MatthewWCook/Z80Project/Z80 RAM and Stack Test/Photos/RAMSTACKSchematic1.jpg

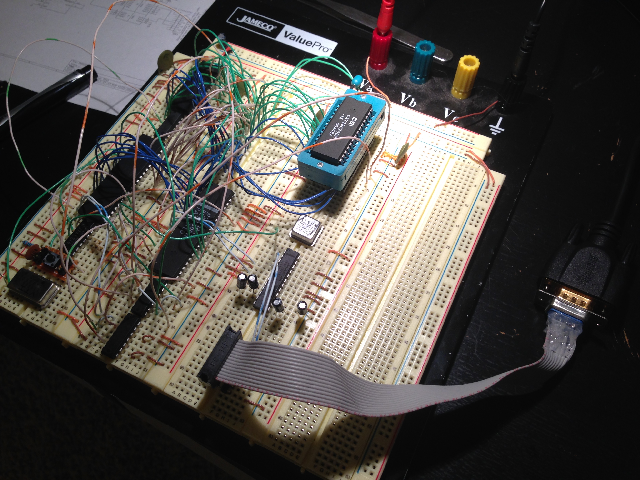
Z80 RAM and Stack Test/Photos/RAMSTACKSchematic1.jpg
