MatthewWCook/Z80Project/Z80 8bit CF Card Part 1/Photos/CFPIC2.PNG

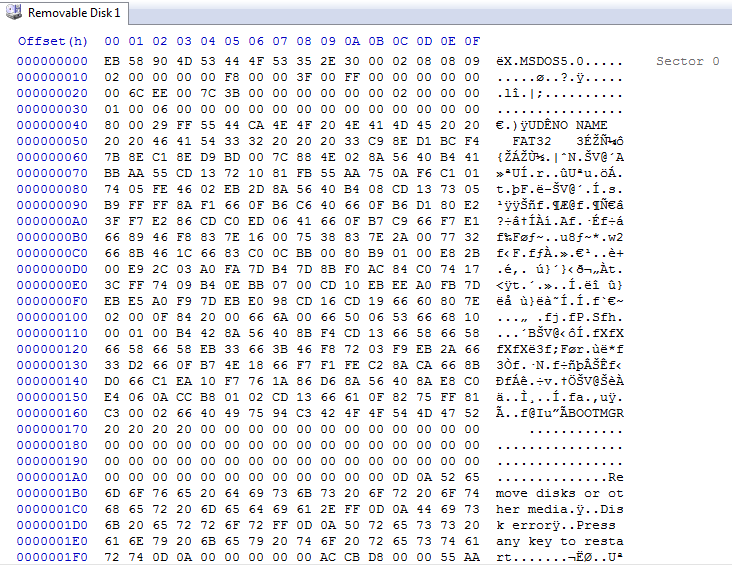
Z80 8bit CF Card Part 1/Photos/CFPIC2.PNG
