MatthewWCook/Z80Project/Z80 8bit CF Card Part 1/Photos/CFPIC3.PNG

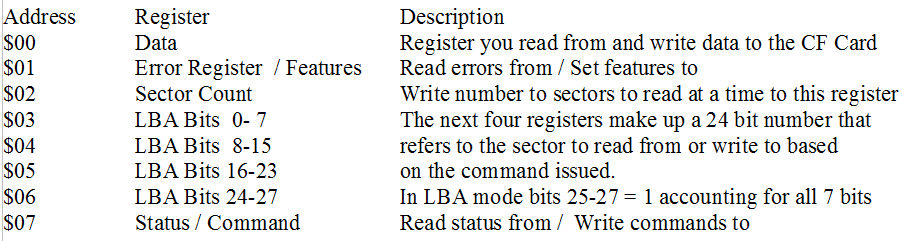
Z80 8bit CF Card Part 1/Photos/CFPIC3.PNG
