MatthewWCook/Z80Project/Z80 8bit CF Card Part 1/Photos/CFPIC4.png

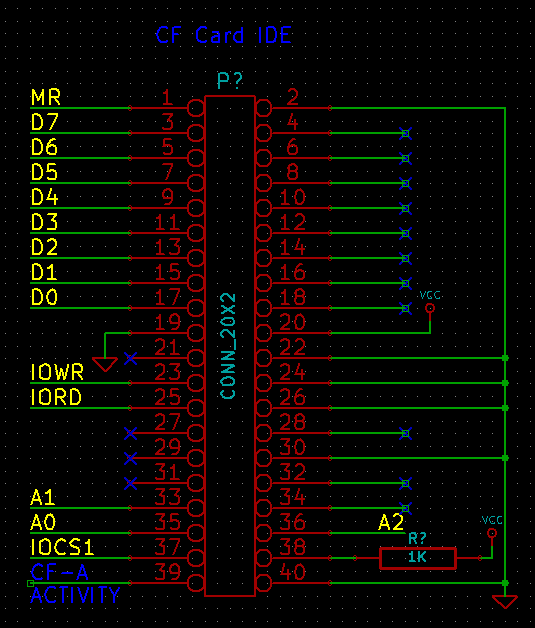
Z80 8bit CF Card Part 1/Photos/CFPIC4.png
