MatthewWCook/Z80Project/Z80 8bit CF Card Part 1/Photos/Photo Jul 05, 4 09 23 PM.jpg

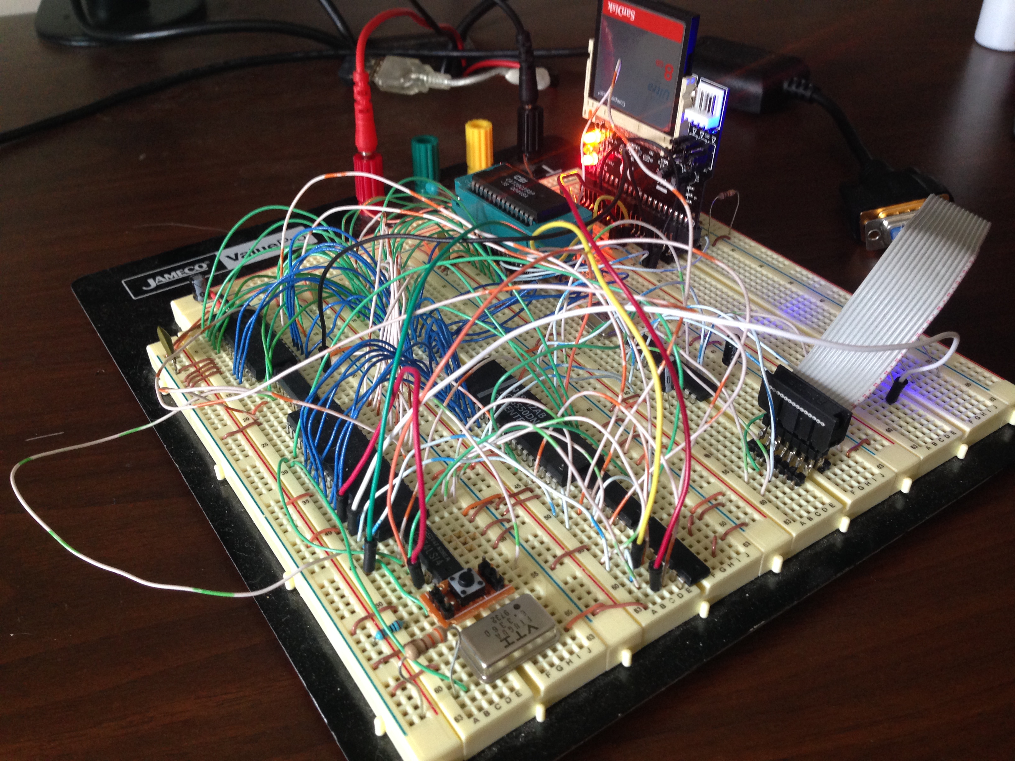
Z80 8bit CF Card Part 1/Photos/Photo Jul 05, 4 09 23 PM.jpg
