MatthewWCook/Z80Project/Z80 8bit CF Card Part 1/Photos/Photo Jul 05, 7 52 12 PM.jpg

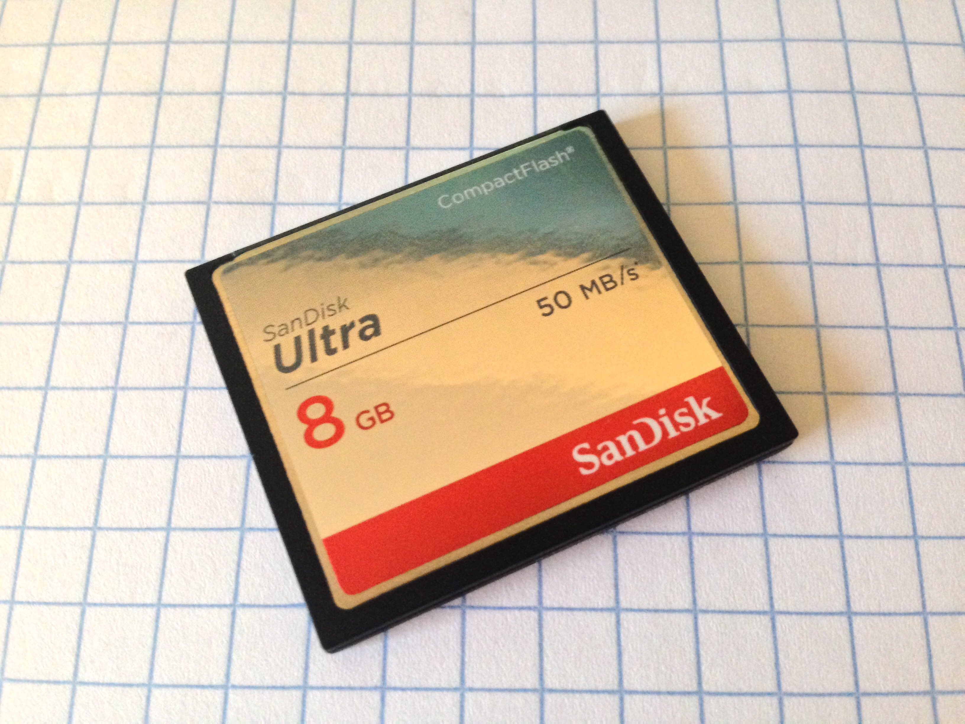
Z80 8bit CF Card Part 1/Photos/Photo Jul 05, 7 52 12 PM.jpg
