MatthewWCook/Z80Project/Z80 Interrupts and Strings/Photos/CAT1.jpg

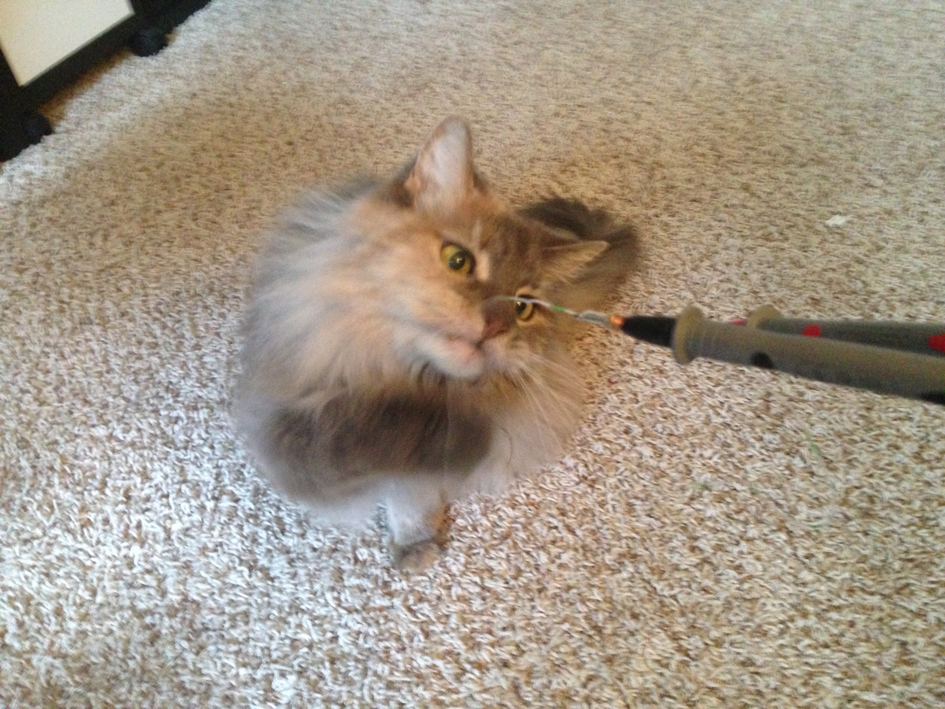
Z80 Interrupts and Strings/Photos/CAT1.jpg
