MatthewWCook/Z80Project/Z80 Interrupts and Strings/Photos/CAT2.jpg

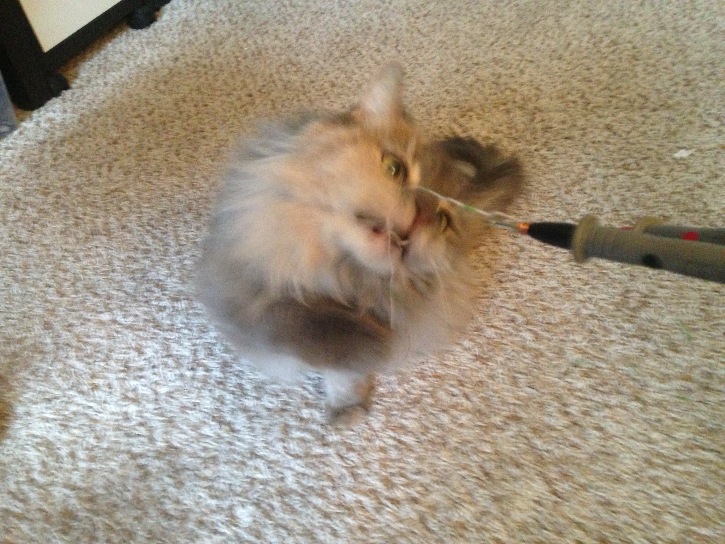
Z80 Interrupts and Strings/Photos/CAT2.jpg
