MatthewWCook/Z80Project/Z80 Interrupts and Strings/Photos/Z80IASOUTPUT.PNG

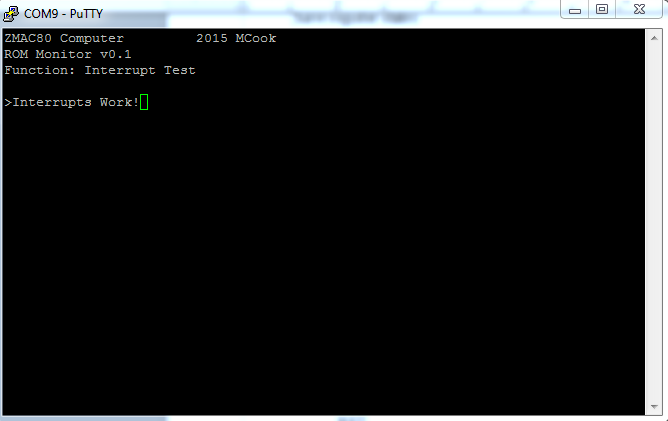
Z80 Interrupts and Strings/Photos/Z80IASOUTPUT.PNG
