MatthewWCook/Z80Project/Z80 Monitor Part 1/ROMMonitorPIC1.PNG

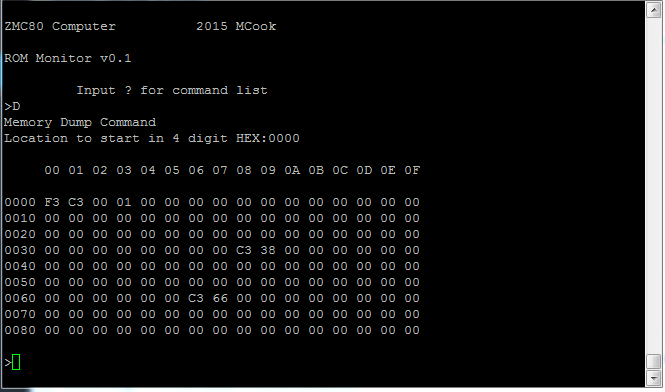
Z80 Monitor Part 1/ROMMonitorPIC1.PNG
