MatthewWCook/Z80Project/Z80 UART Serial Console Interface/Pictures/Photo1.jpg

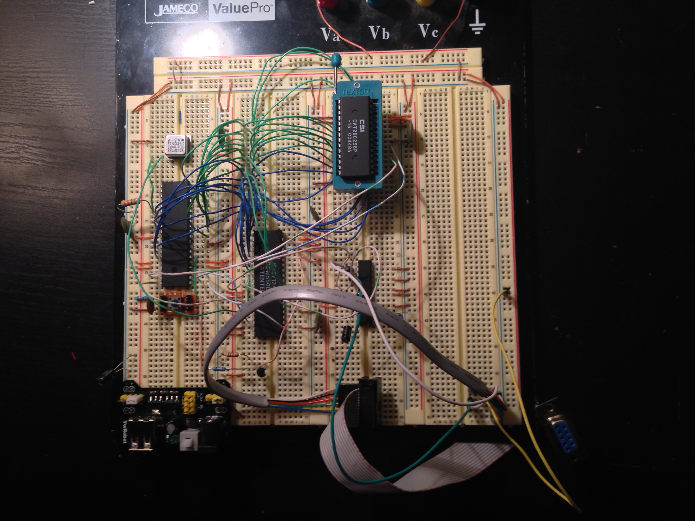
Z80 UART Serial Console Interface/Pictures/Photo1.jpg
