MatthewWCook/Z80Project/Z80 UART Serial Console Interface/Pictures/Photo2.jpg

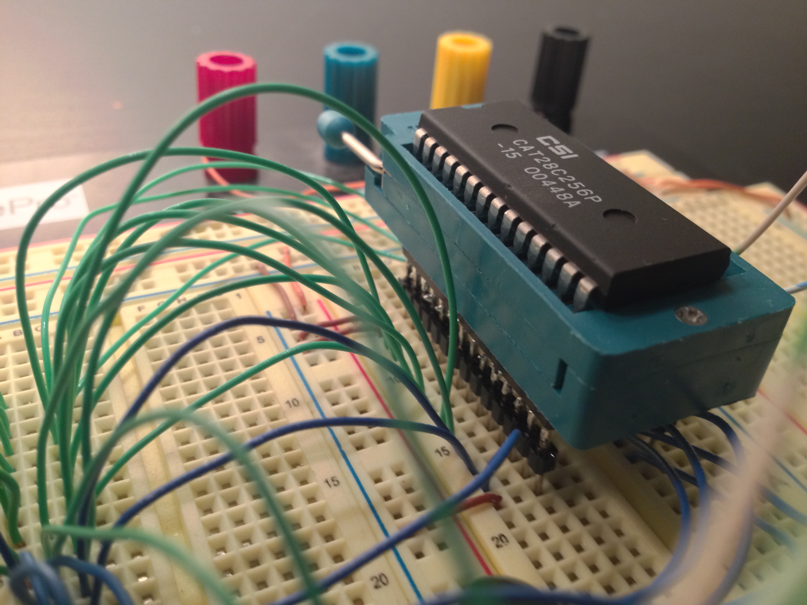
Z80 UART Serial Console Interface/Pictures/Photo2.jpg
