MatthewWCook/Z80Project/Z80 UART Serial Console Interface/Pictures/Photo3.jpg

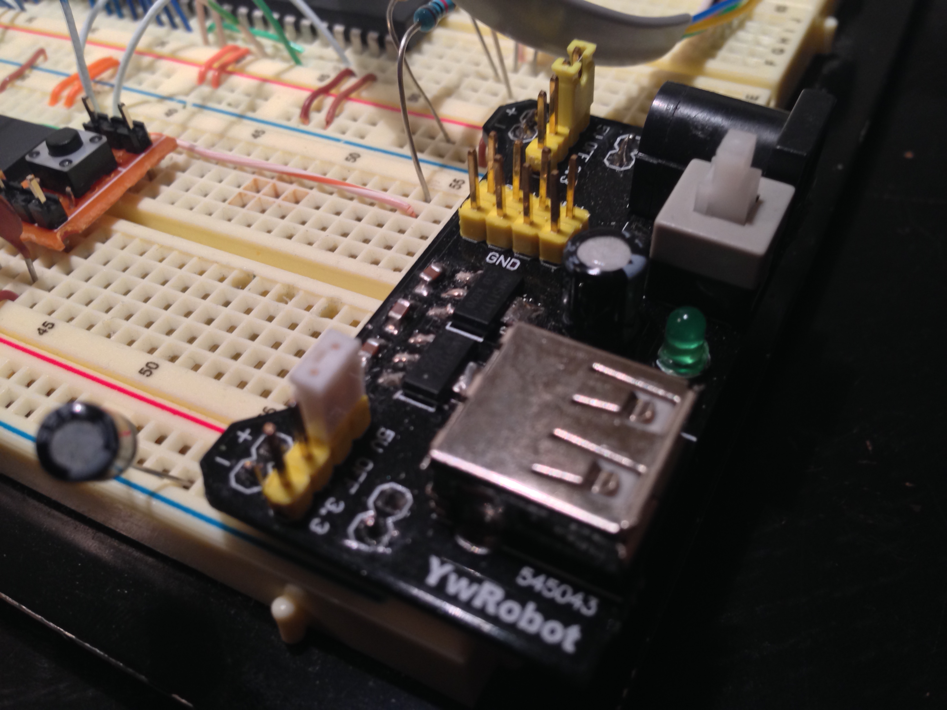
Z80 UART Serial Console Interface/Pictures/Photo3.jpg
