MatthewWCook/Z80Project/(list of files, cad)

Other CAD files:
Z80 8bit CF Card Part 1/Code/Z80Monitor.obj
Z80 Interrupts and Strings/Code/Z80Interrupt.obj
Z80 RAM and Stack Test/Code/STACKTEST.obj
Z80 UART Serial Console Interface/Code/UARTCONSOLE.obj
Z80 Monitor Part 1/Code/Z80Monitor.obj
