MatthewWCook/Z80Project/Z80 RAM and Stack Test/Photos/Output.PNG

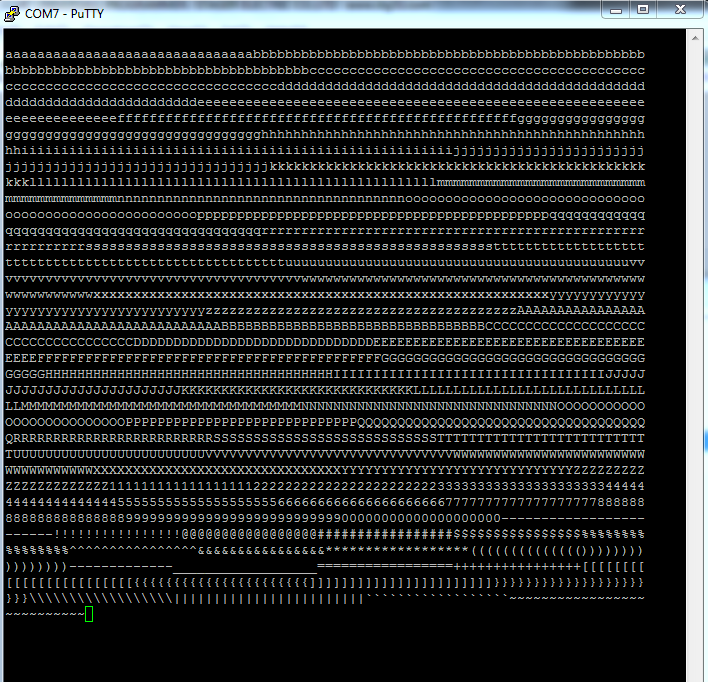
Z80 RAM and Stack Test/Photos/Output.PNG
