MatthewWCook/Z80Project/Z80 8bit CF Card Part 1/Schematic/PDF/Z80CFHDD1-bw.pdf

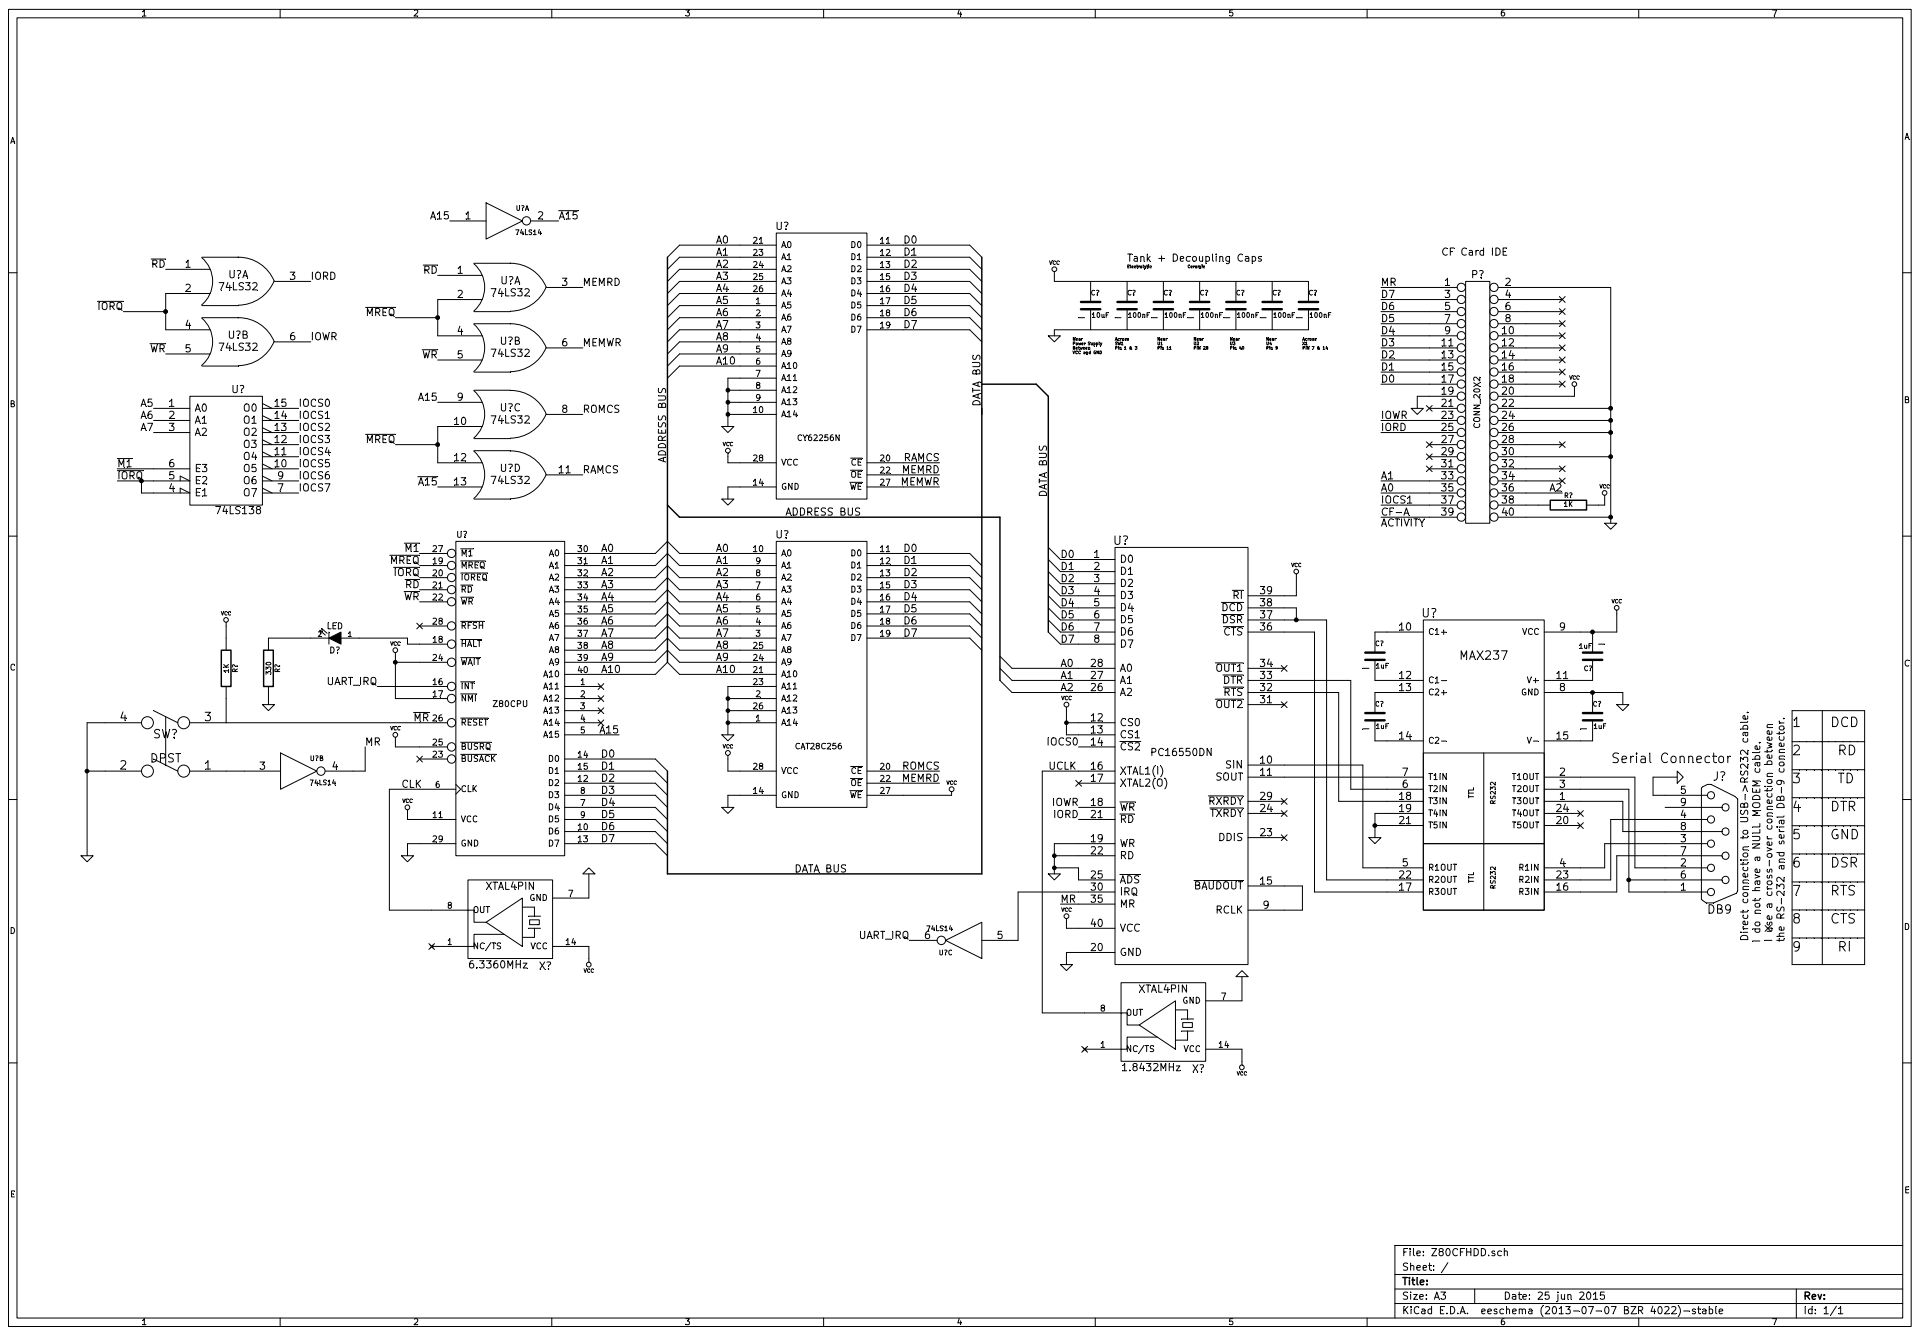
[picture p17: page 1]
