MatthewWCook/Z80Project/Z80 8bit CF Card Part 1/Schematic/PDF/Z80CFHDD1-color.pdf

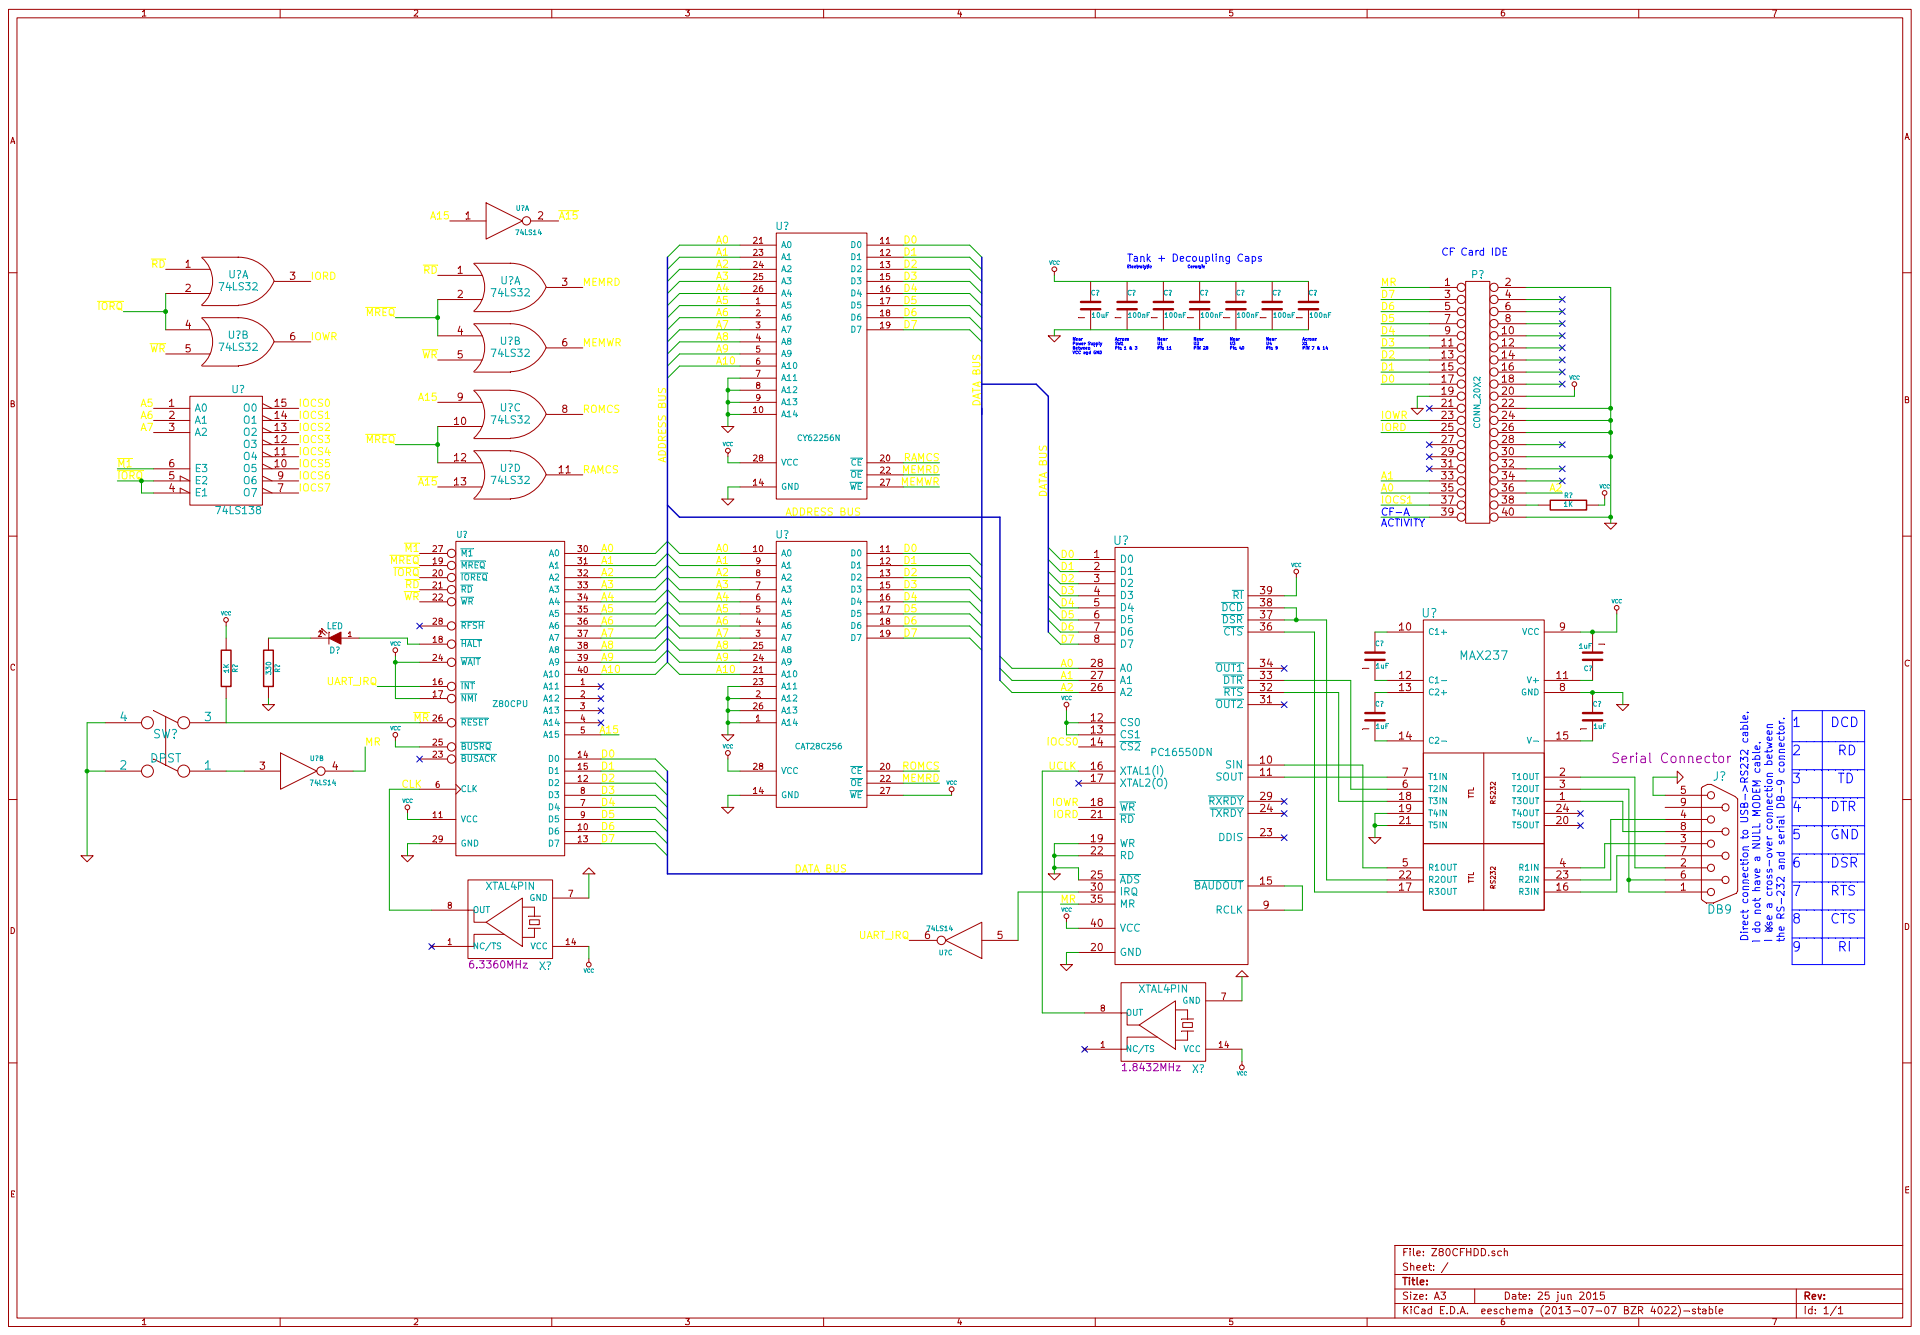
[picture p18: page 1]
