MatthewWCook/Z80Project/Z80 Interrupts and Strings/Schematic/PDF/Z80INTERRUPTSANDSTRINGS-bw.pdf

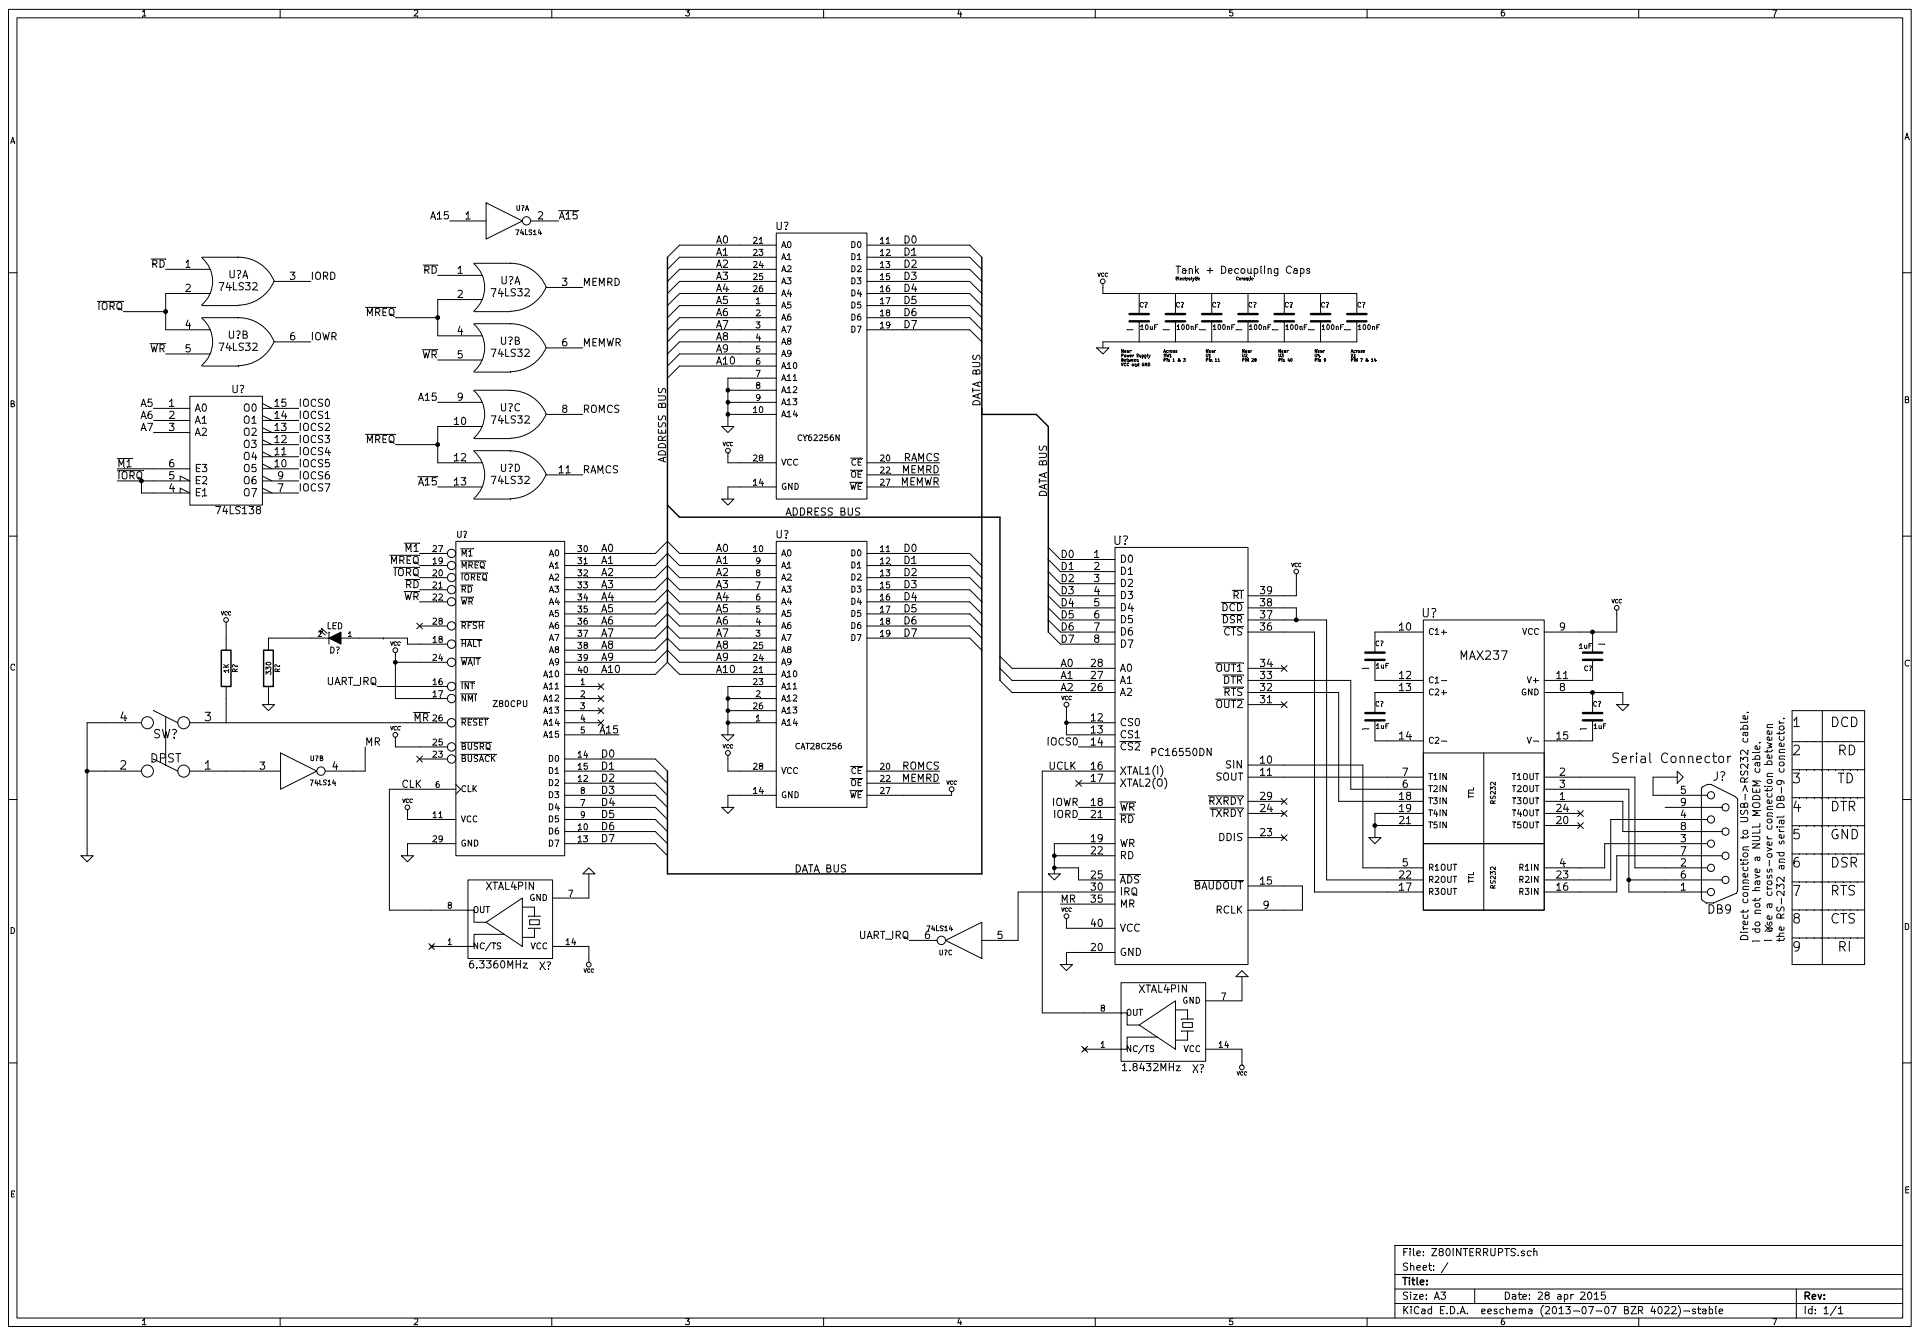
[picture p19: page 1]
