MatthewWCook/Z80Project/Z80 Interrupts and Strings/Schematic/PDF/Z80INTERRUPTSANDSTRINGS-color.pdf

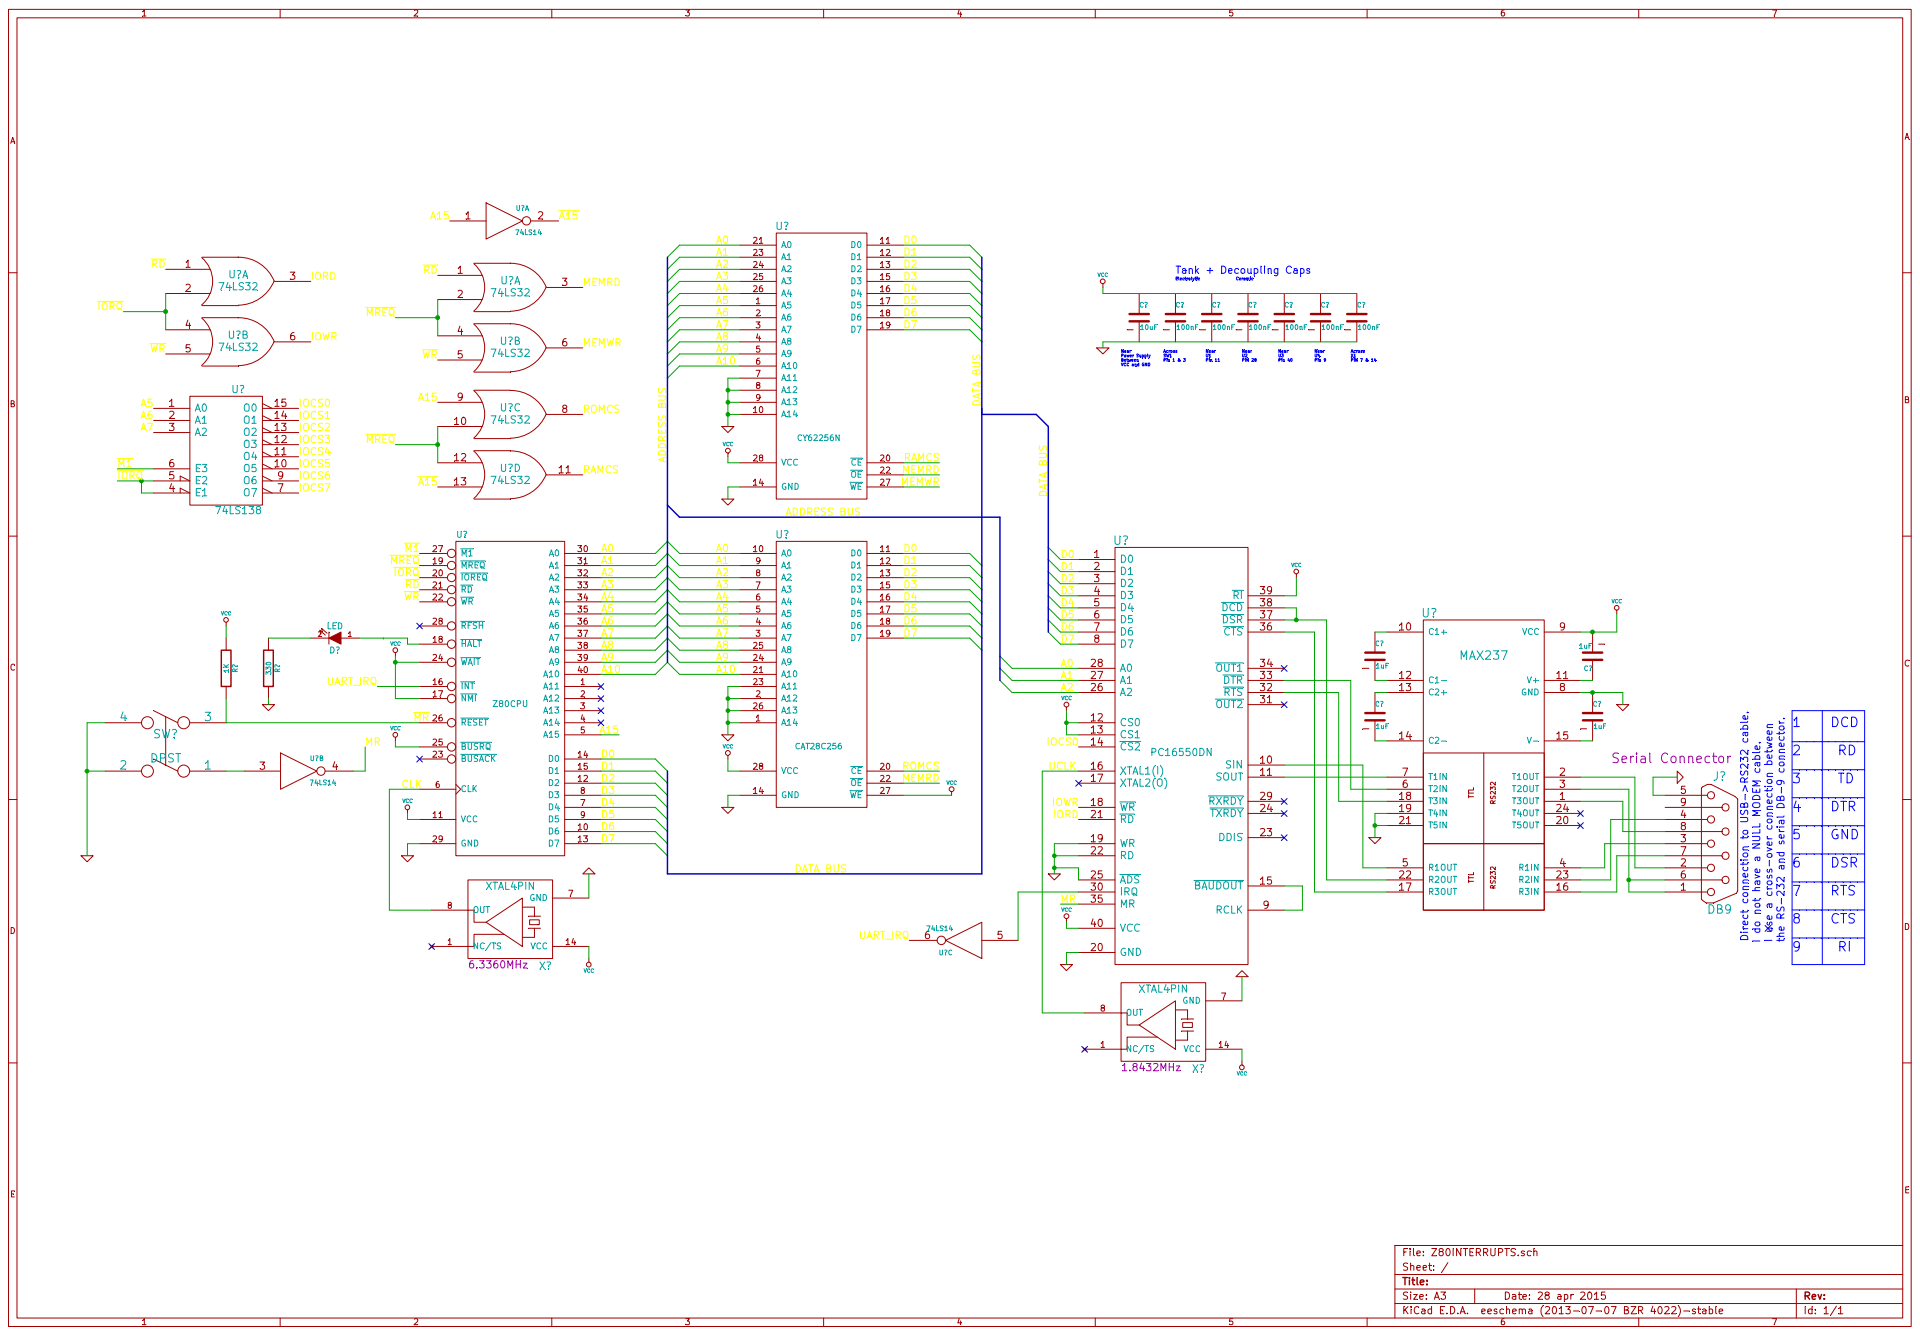
[picture p20: page 1]
