MatthewWCook/Z80Project/Z80 RAM and Stack Test/Schematic/PDF/Z80RAMSTACKTEST-bw.pdf

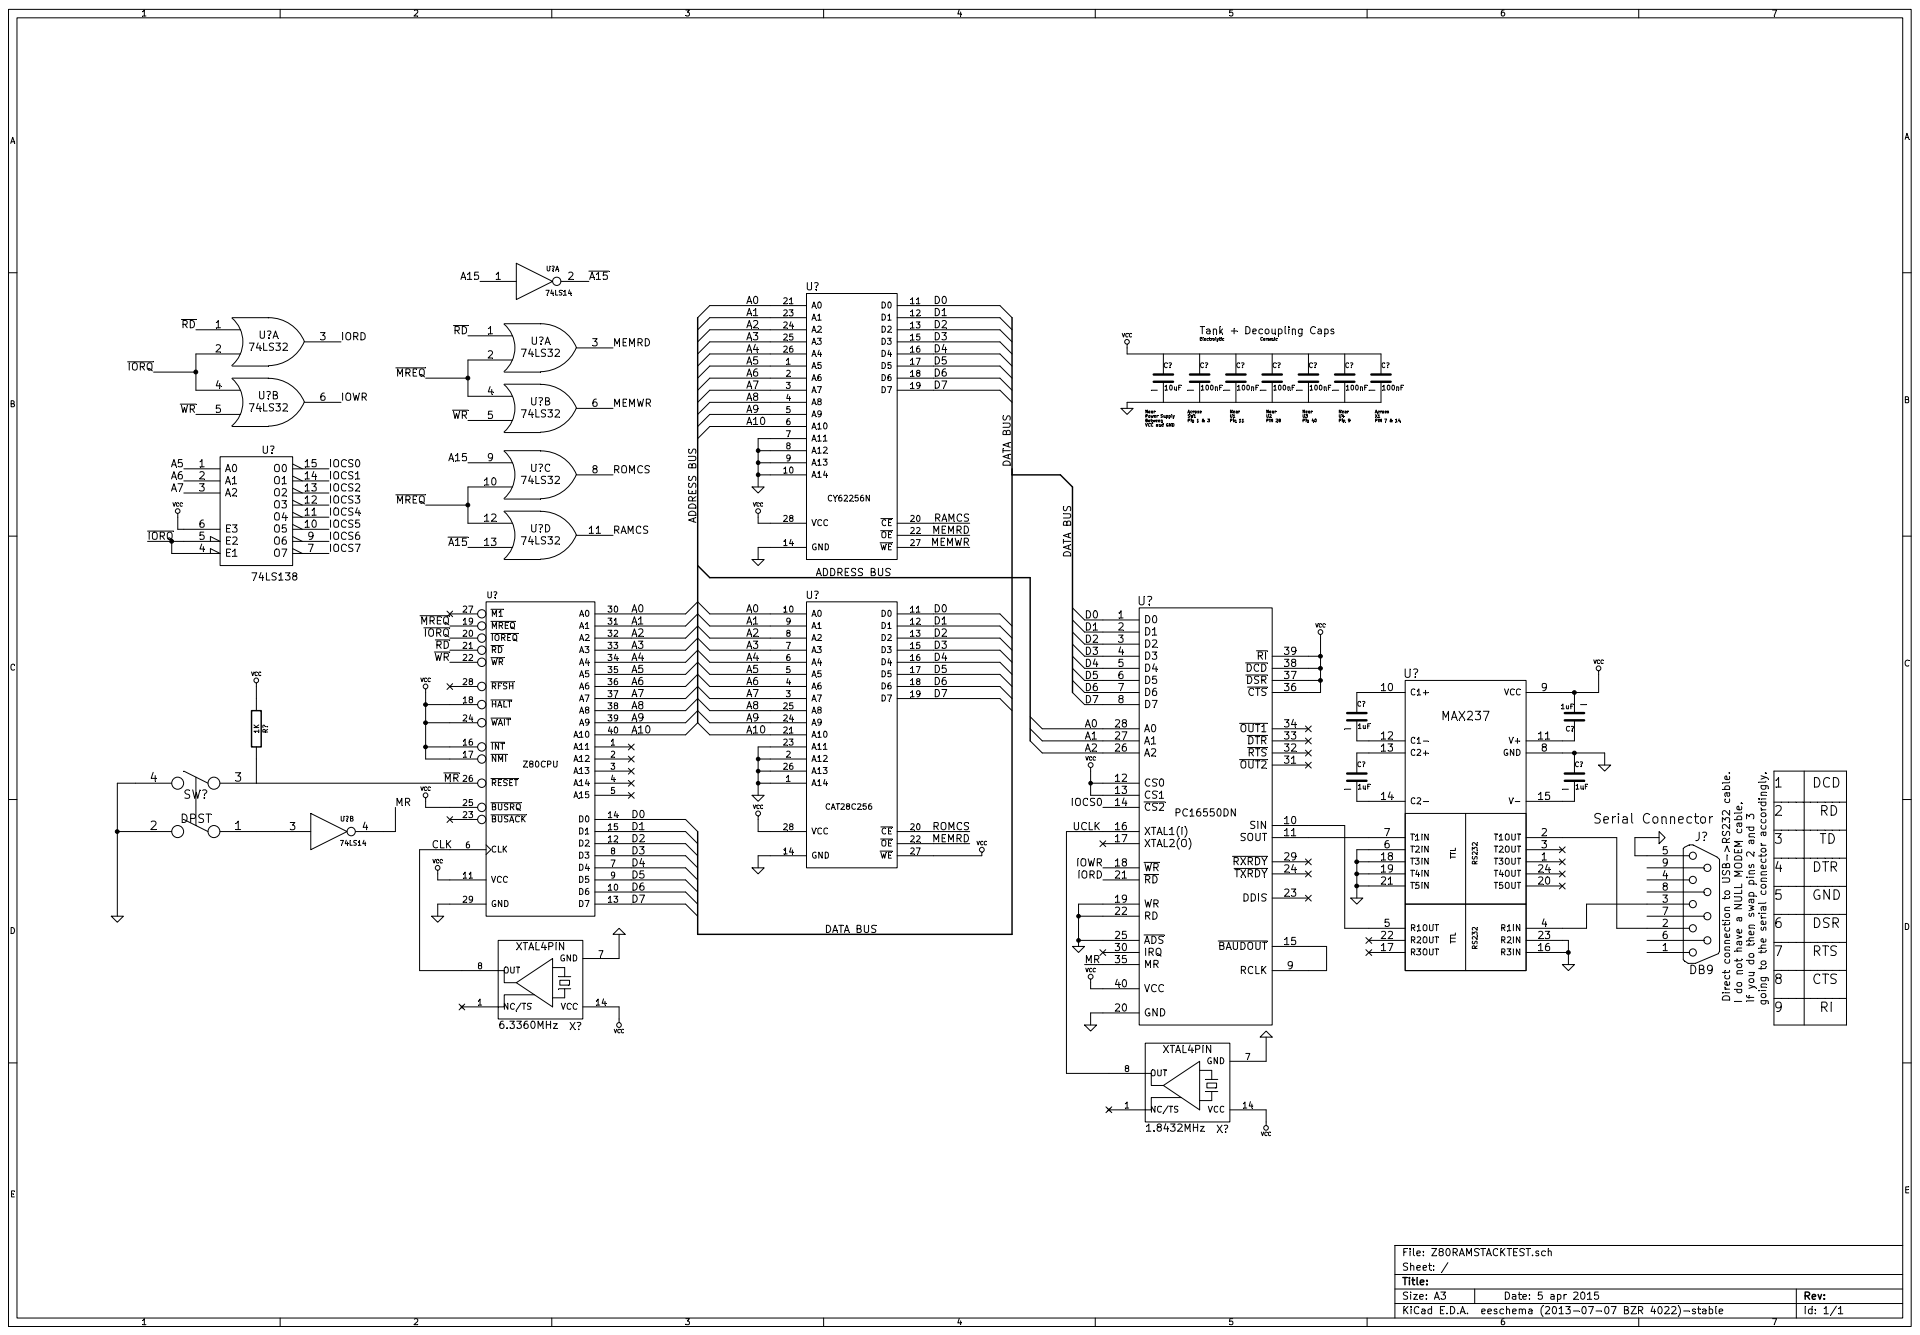
[picture p21: page 1]
