MatthewWCook/Z80Project/Z80 RAM and Stack Test/Schematic/PDF/Z80RAMSTACKTEST-color.pdf

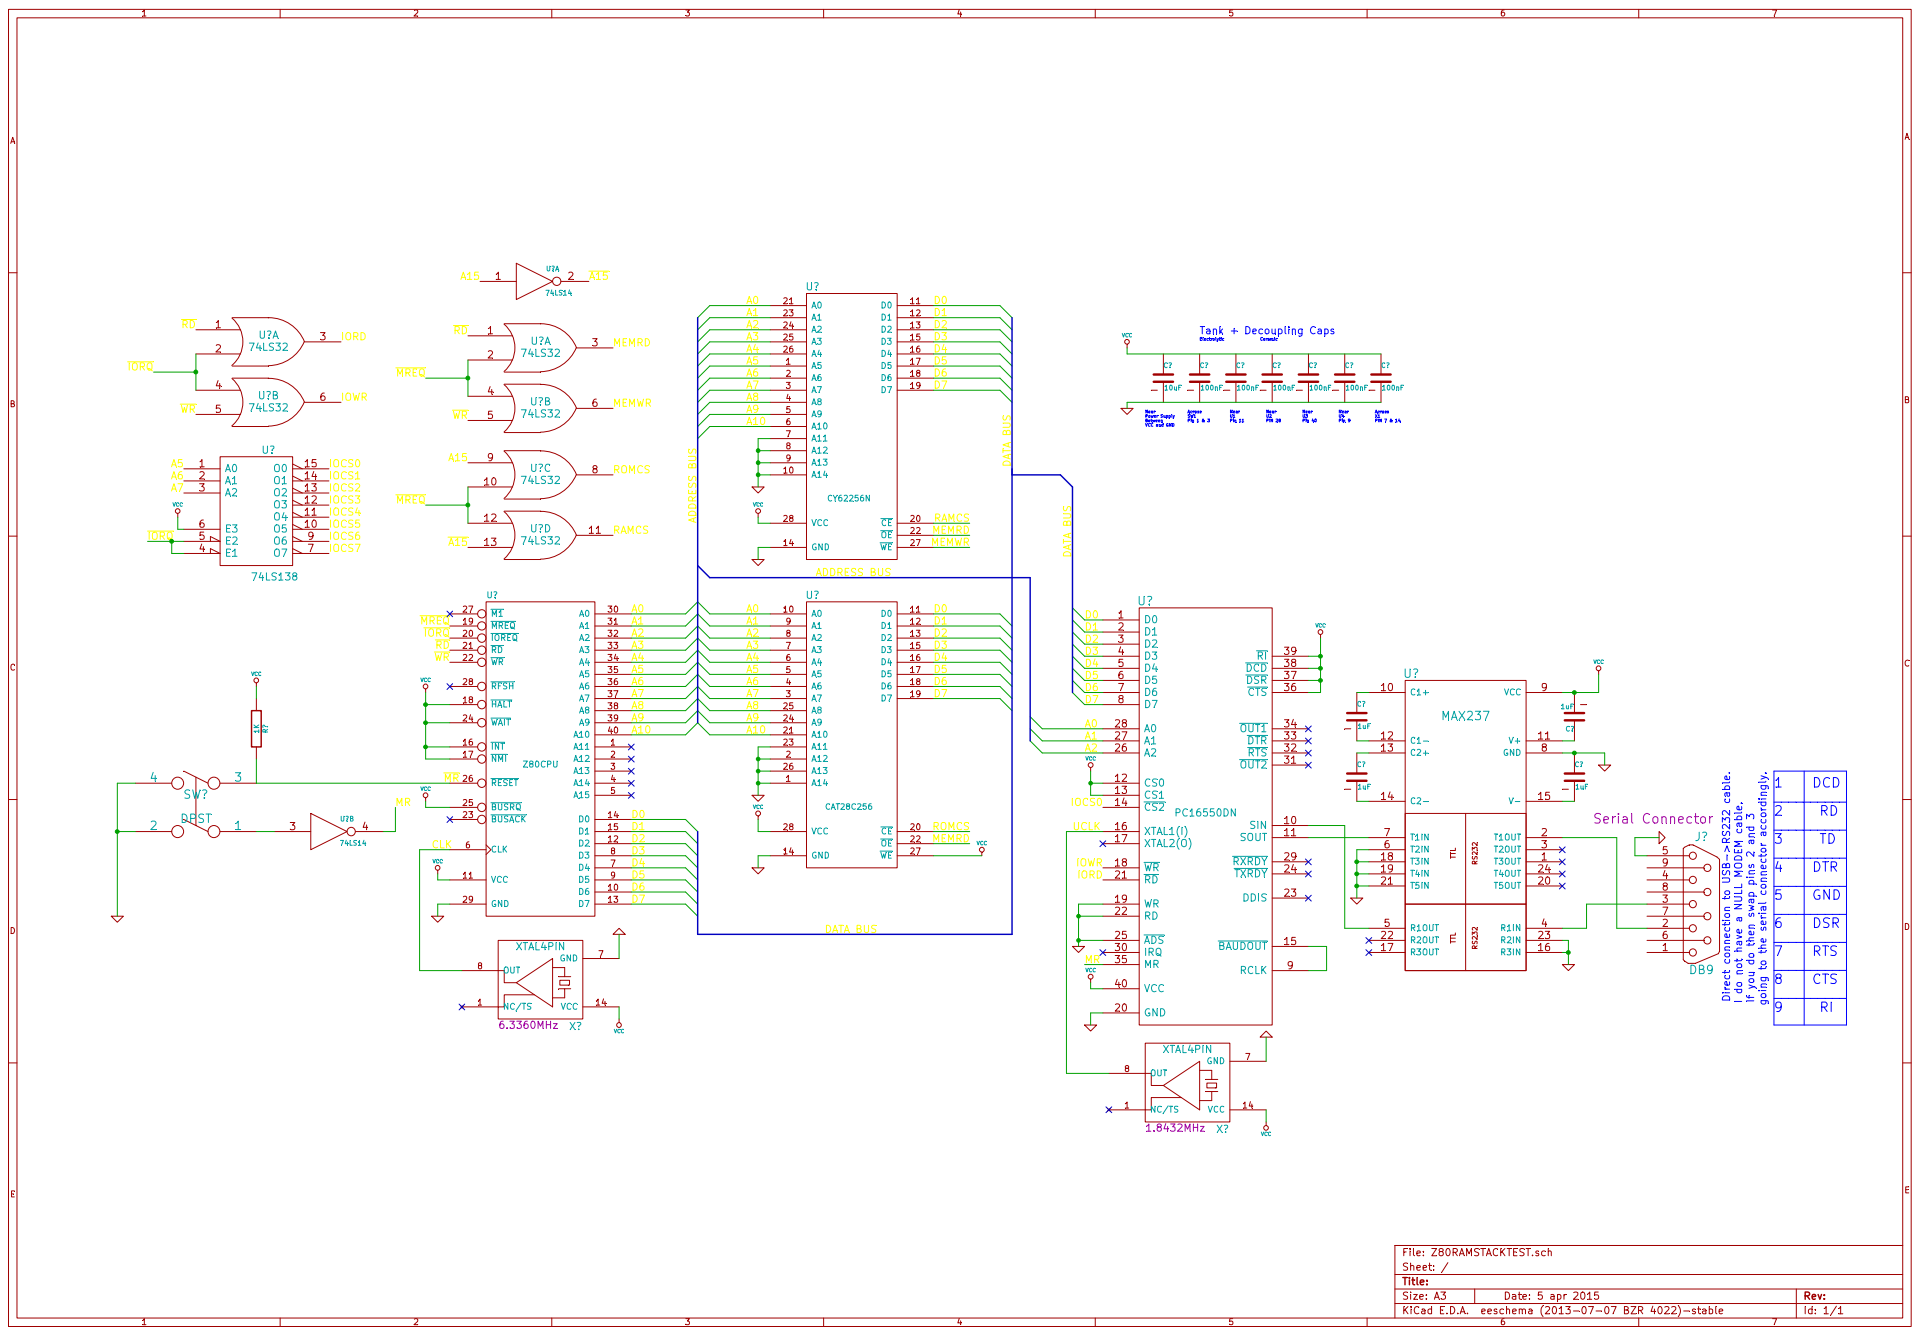
[picture p22: page 1]
