MatthewWCook/Z80Project/Z80 UART Serial Console Interface/Schematic/PDF/Z80USCI-bw.pdf

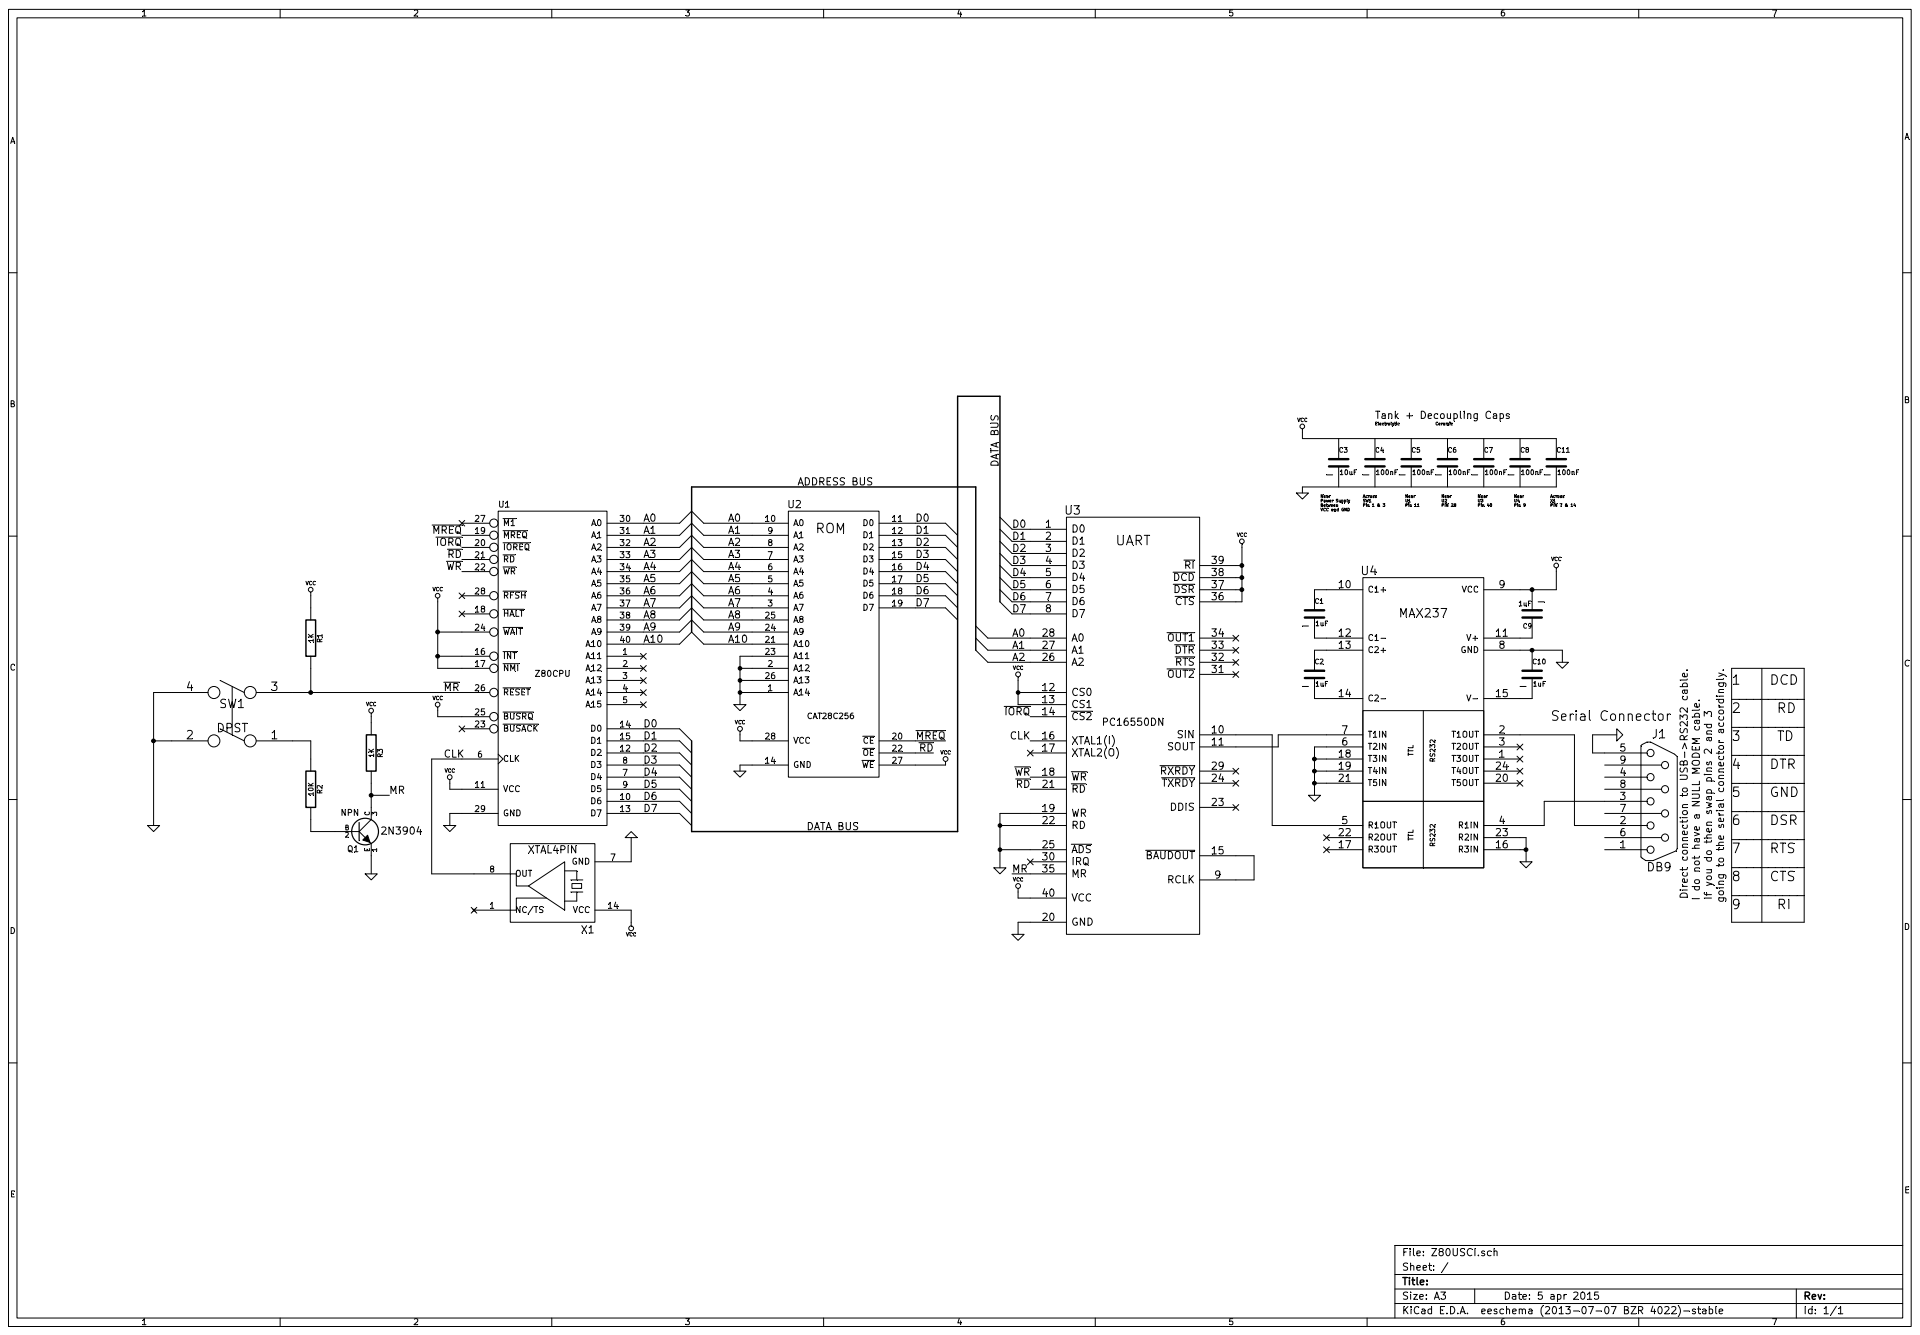
[picture p23: page 1]
