MatthewWCook/Z80Project/Z80 Low-Freqency Clock Generator/Schematic/PDF/LFSWG.pdf

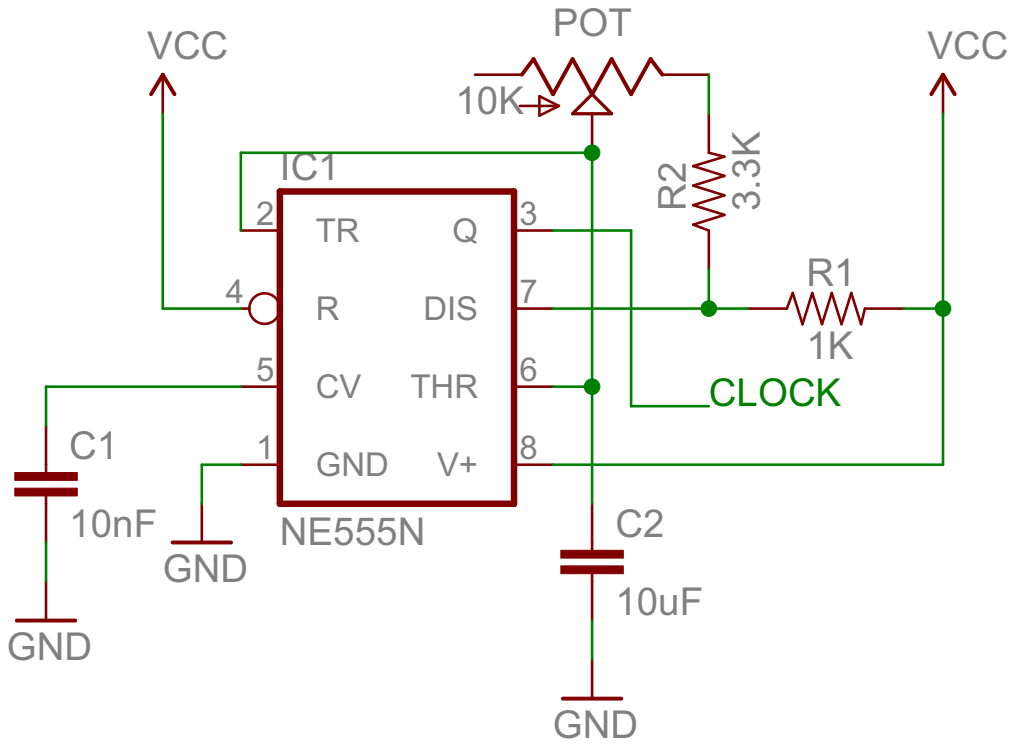
[picture p24: page 1]
