MatthewWCook/Z80Project/Z80 ROM Test/Schematic/PDF/Z80RT.pdf

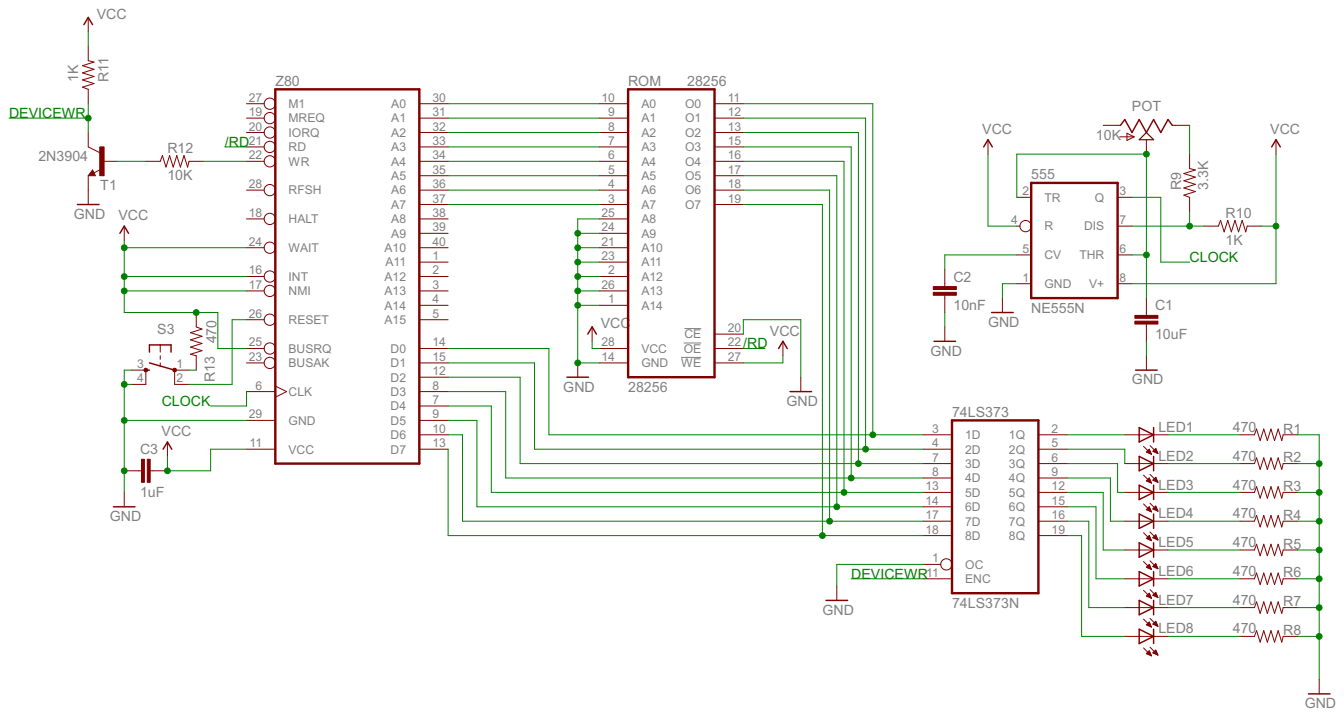
[picture p25: page 1]
