MatthewWCook/Z80Project/Z80 Test Circuit/Schematic/PDF/Z80TestCircuit.pdf

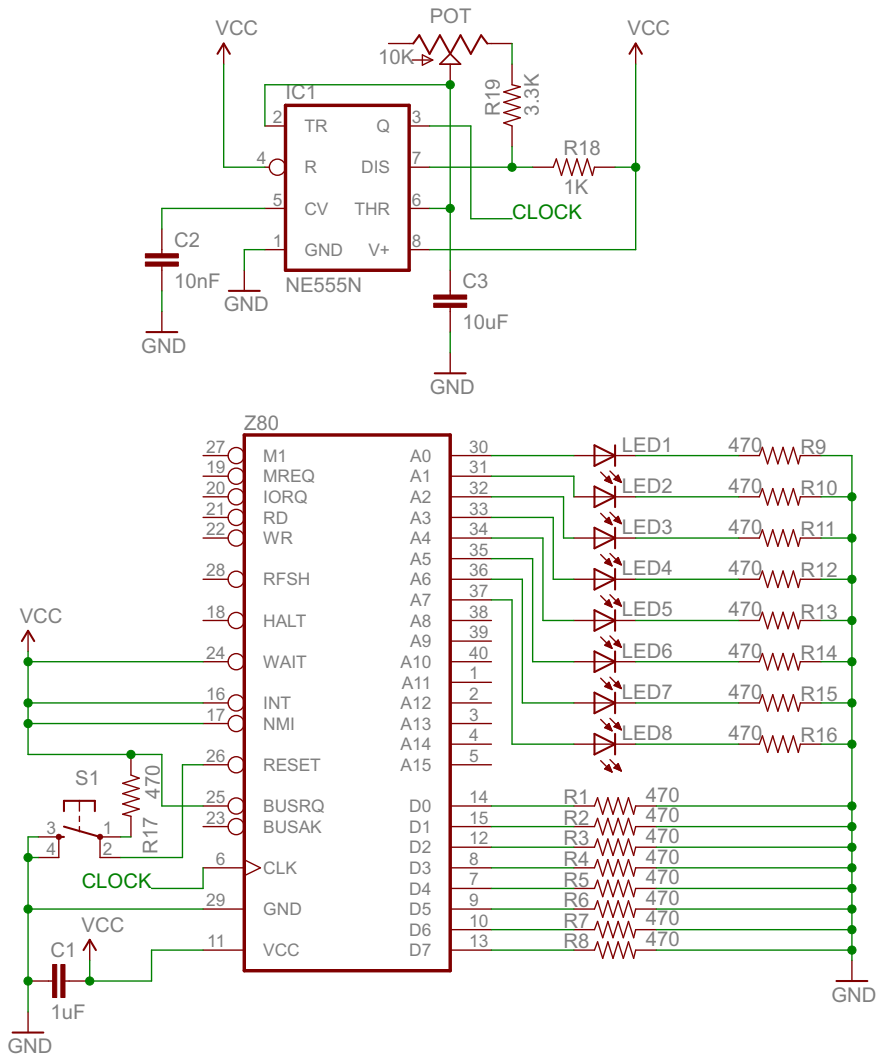
[picture p26: page 1]
