MatthewWCook/Z80Project/Z80 UART Serial Console Interface/Schematic/PDF/Z80USCI-color.pdf

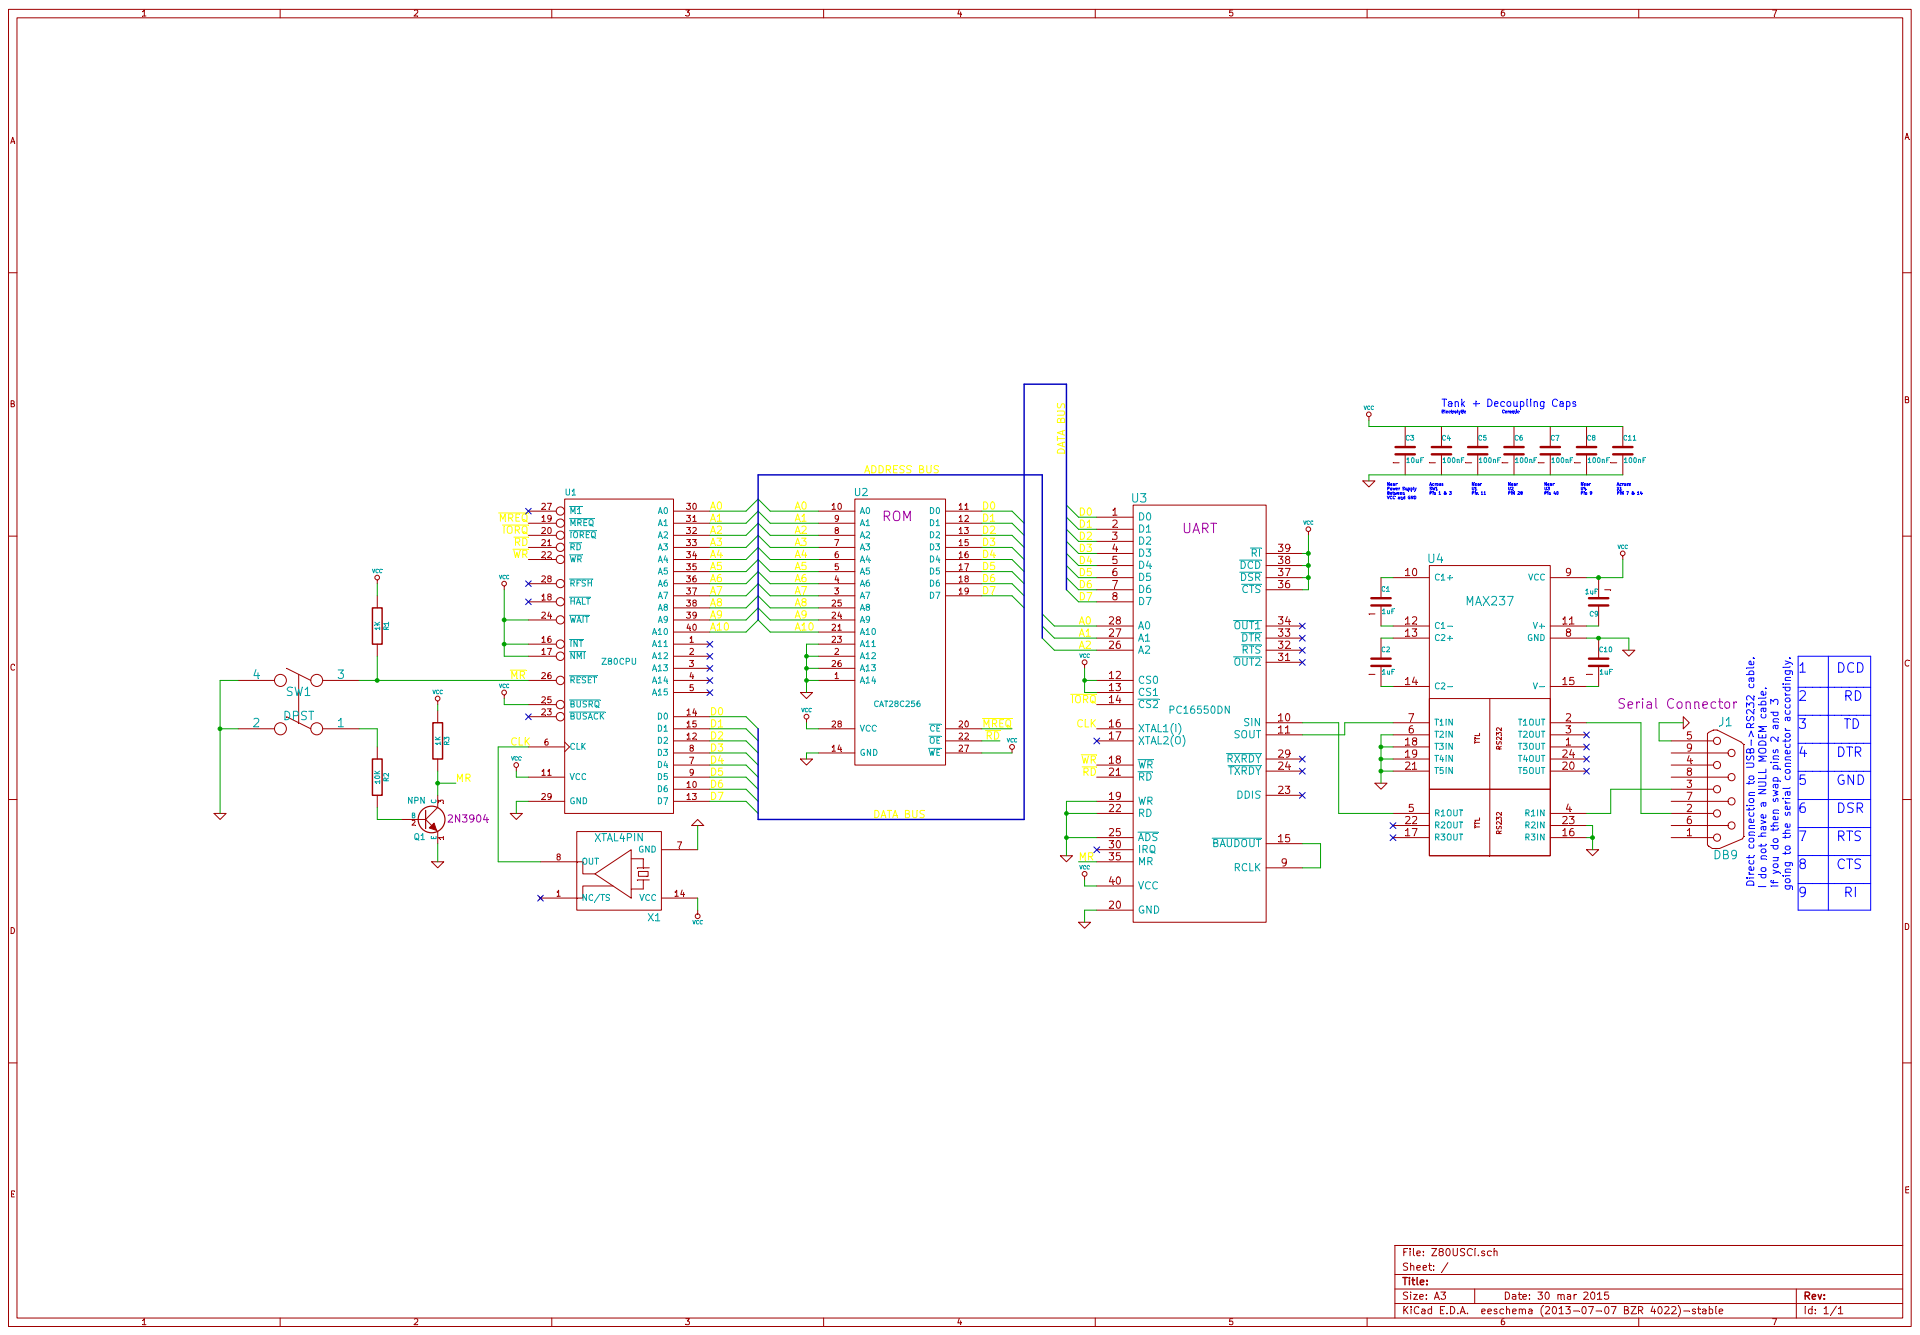
[picture p27: page 1]
