MatthewWCook/Z80Project/Z80 UART Transmit Test/Schematic/PDF/Z80UARTTEST.pdf

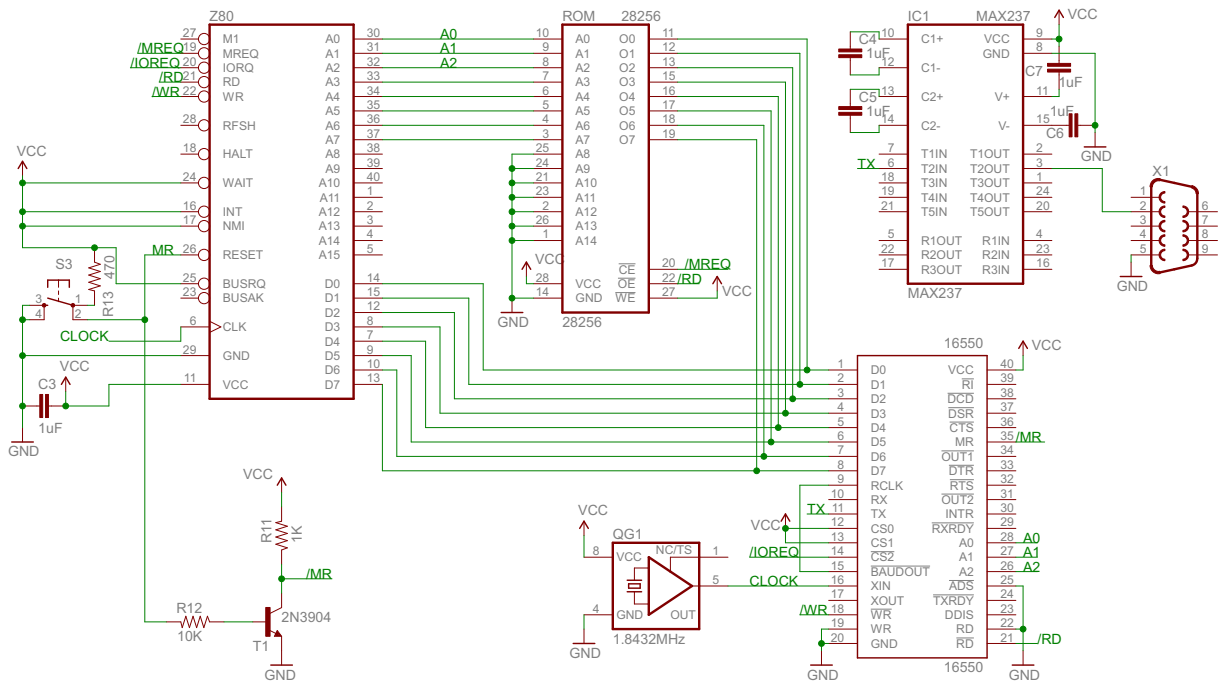
[picture p28: page 1]
