MatthewWCook/Z80Project/Z80 Low-Freqency Clock Generator/Schematic/Eagle/LFSWG.sch

## EAGLE design Z80 Low-Freqency Clock Generator/Schematic/Eagle/LFSWG.sch (2015-04-02)

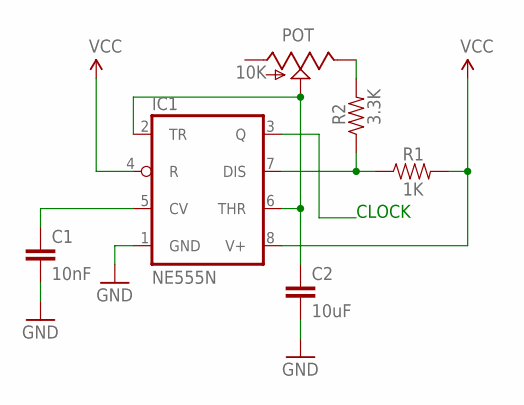
[picture p29: schematic LFSWG.sch]

Parts:
C1: 10nF; E5-5
C2: 10uF; E5-5
IC1: NE555N; DIL08-ROUND
POT: 10K; POT_ALPHA_RV16AF-20
R1: 1K; AXIAL-0.4
R2: 3.3K; AXIAL-0.4

Connections:
GND: C1.- (2), C2.- (2), IC1.1 (GND)
unnamed: IC1.7 (DIS), R1.P$1 (1), R2.P$1 (1)
unnamed: C2.+ (1), IC1.2 (TR), IC1.6 (THR), POT.2 (S)
unnamed: C1.+ (1), IC1.5 (CV)
unnamed: POT.3 (E), R2.P$2 (2)
VCC: IC1.4 (R), IC1.8 (V+), R1.P$2 (2)

Notes on the sheet:
CLOCK
