MatthewWCook/Z80Project/Z80 ROM Test/Schematic/Eagle/Z80RT.sch

## EAGLE design Z80 ROM Test/Schematic/Eagle/Z80RT.sch (2015-04-02)

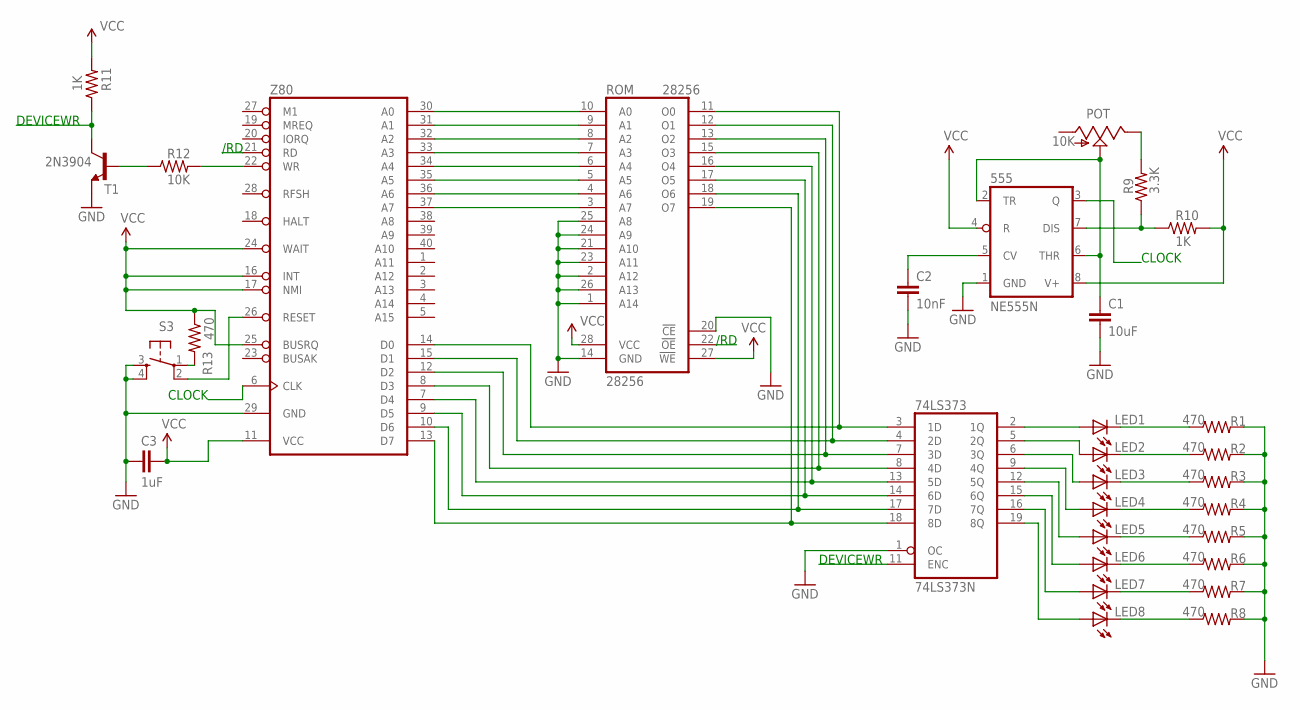
[picture p30: schematic Z80RT.sch]

Parts:
74LS373: 74LS373N; DIL20
555: NE555N; DIL08-ROUND
C1: 10uF; E5-5
C2: 10nF; E5-5
C3: 1uF; E5-5
LED1, LED2, LED3, LED4, LED5, LED6, LED7, LED8: LED5MM
POT: 10K; POT_ALPHA_RV16AF-20
R1, R2, R3, R4, R5, R6, R7, R8, R13: 470; AXIAL-0.4
R9: 3.3K; AXIAL-0.4
R10, R11: 1K; AXIAL-0.4
R12: 10K; AXIAL-0.4
ROM: 28256; DIL28
S3: TAC_SWITCHPTH; TACTILE-PTH
T1: 2N3904; TO92
Z80: Z80CPU; DIL40

Connections:
/RD: ROM.22 (!OE), Z80.21 (RD)
CLOCK: 555.3 (Q), Z80.6 (CLK)
DEVICEWR: 74LS373.11 (ENC), R11.P$1 (1), T1.1 (C)
GND: 74LS373.1 (OC), 555.1 (GND), C1.- (2), C2.- (2), C3.- (2), R1.P$2 (2), R2.P$2 (2), R3.P$2 (2), R4.P$2 (2), R5.P$2 (2), R6.P$2 (2), R7.P$2 (2), R8.P$2 (2), ROM.1 (A14), ROM.2 (A12), ROM.14 (GND), ROM.20 (!CE), ROM.21 (A10), ROM.23 (A11), ROM.24 (A9), ROM.25 (A8), ROM.26 (A13), S3.3, S3.4, T1.3 (E), Z80.29 (GND)
unnamed: R12.P$2 (2), Z80.22 (WR)
unnamed: 74LS373.3 (1D), ROM.11 (O0), Z80.14 (D0)
unnamed: 74LS373.4 (2D), ROM.12 (O1), Z80.15 (D1)
unnamed: 74LS373.7 (3D), ROM.13 (O2), Z80.12 (D2)
unnamed: 74LS373.8 (4D), ROM.15 (O3), Z80.8 (D3)
unnamed: 74LS373.13 (5D), ROM.16 (O4), Z80.7 (D4)
unnamed: 74LS373.14 (6D), ROM.17 (O5), Z80.9 (D5)
unnamed: 74LS373.17 (7D), ROM.18 (O6), Z80.10 (D6)
unnamed: 74LS373.18 (8D), ROM.19 (O7), Z80.13 (D7)
unnamed: ROM.10 (A0), Z80.30 (A0)
unnamed: ROM.9 (A1), Z80.31 (A1)
unnamed: ROM.8 (A2), Z80.32 (A2)
unnamed: ROM.7 (A3), Z80.33 (A3)
unnamed: ROM.6 (A4), Z80.34 (A4)
unnamed: ROM.5 (A5), Z80.35 (A5)
unnamed: ROM.4 (A6), Z80.36 (A6)
unnamed: ROM.3 (A7), Z80.37 (A7)
unnamed: R12.P$1 (1), T1.2 (B)
unnamed: LED1.K (C), R1.P$1 (1)
unnamed: LED2.K (C), R2.P$1 (1)
unnamed: LED3.K (C), R3.P$1 (1)
unnamed: LED4.K (C), R4.P$1 (1)
unnamed: LED5.K (C), R5.P$1 (1)
unnamed: LED6.K (C), R6.P$1 (1)
unnamed: LED7.K (C), R7.P$1 (1)
unnamed: S3.2, Z80.26 (RESET)
unnamed: R13.P$2 (2), S3.1
unnamed: LED8.K (C), R8.P$1 (1)
unnamed: 555.7 (DIS), R9.P$1 (1), R10.P$1 (1)
unnamed: 555.2 (TR), 555.6 (THR), C1.+ (1), POT.2 (S)
unnamed: 555.5 (CV), C2.+ (1)
unnamed: 74LS373.2 (1Q), LED1.A
unnamed: POT.3 (E), R9.P$2 (2)
unnamed: 74LS373.5 (2Q), LED2.A
unnamed: 74LS373.6 (3Q), LED3.A
unnamed: 74LS373.9 (4Q), LED4.A
unnamed: 74LS373.12 (5Q), LED5.A
unnamed: 74LS373.15 (6Q), LED6.A
unnamed: 74LS373.16 (7Q), LED7.A
unnamed: 74LS373.19 (8Q), LED8.A
VCC: 555.4 (R), 555.8 (V+), C3.+ (1), R10.P$2 (2), R11.P$2 (2), R13.P$1 (1), ROM.27 (!WE), ROM.28 (VCC), Z80.11 (VCC), Z80.16 (INT), Z80.17 (NMI), Z80.24 (WAIT), Z80.25 (BUSRQ)

Notes on the sheet:
CLOCK
/RD
DEVICEWR
