MatthewWCook/Z80Project/Z80 Test Circuit/Schematic/Eagle/Z80TestCircuit.sch

## EAGLE design Z80 Test Circuit/Schematic/Eagle/Z80TestCircuit.sch (2015-04-02)

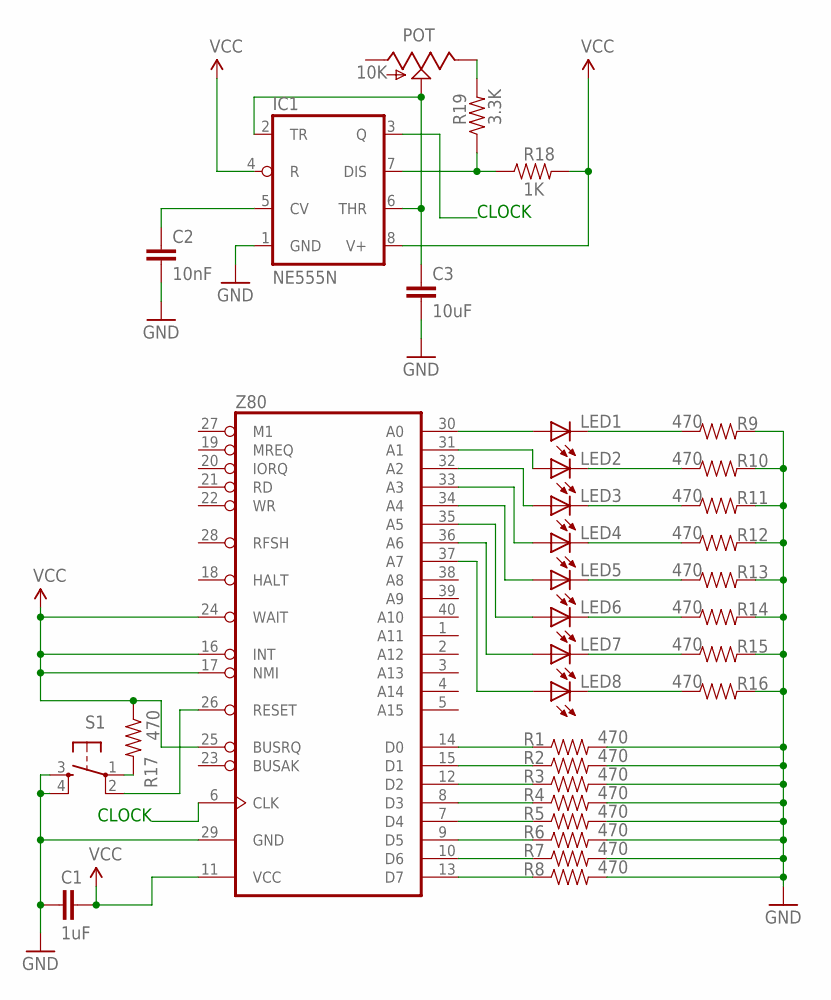
[picture p31: schematic Z80TestCircuit.sch]

Parts:
C1: 1uF; E5-5
C2: 10nF; E5-5
C3: 10uF; E5-5
IC1: NE555N; DIL08-ROUND
LED1, LED2, LED3, LED4, LED5, LED6, LED7, LED8: LED5MM
POT: 10K; POT_ALPHA_RV16AF-20
R1, R2, R3, R4, R5, R6, R7, R8, R9, R10, R11, R12, R13, R14, R15, R16, R17: 470; AXIAL-0.4
R18: 1K; AXIAL-0.4
R19: 3.3K; AXIAL-0.4
S1: TAC_SWITCHPTH; TACTILE-PTH
Z80: Z80CPU; DIL40

Connections:
GND: C1.- (2), C2.- (2), C3.- (2), IC1.1 (GND), R1.P$2 (2), R2.P$2 (2), R3.P$2 (2), R4.P$2 (2), R5.P$2 (2), R6.P$2 (2), R7.P$2 (2), R8.P$2 (2), R9.P$2 (2), R10.P$2 (2), R11.P$2 (2), R12.P$2 (2), R13.P$2 (2), R14.P$2 (2), R15.P$2 (2), R16.P$2 (2), S1.3, S1.4, Z80.29 (GND)
unnamed: R1.P$1 (1), Z80.14 (D0)
unnamed: R2.P$1 (1), Z80.15 (D1)
unnamed: R3.P$1 (1), Z80.12 (D2)
unnamed: R4.P$1 (1), Z80.8 (D3)
unnamed: R5.P$1 (1), Z80.7 (D4)
unnamed: R6.P$1 (1), Z80.9 (D5)
unnamed: R7.P$1 (1), Z80.10 (D6)
unnamed: R8.P$1 (1), Z80.13 (D7)
unnamed: LED1.K (C), R9.P$1 (1)
unnamed: LED2.K (C), R10.P$1 (1)
unnamed: LED3.K (C), R11.P$1 (1)
unnamed: LED4.K (C), R12.P$1 (1)
unnamed: LED5.K (C), R13.P$1 (1)
unnamed: LED6.K (C), R14.P$1 (1)
unnamed: LED7.K (C), R15.P$1 (1)
unnamed: LED8.K (C), R16.P$1 (1)
unnamed: LED1.A, Z80.30 (A0)
unnamed: LED2.A, Z80.31 (A1)
unnamed: LED3.A, Z80.32 (A2)
unnamed: LED4.A, Z80.33 (A3)
unnamed: LED5.A, Z80.34 (A4)
unnamed: LED6.A, Z80.35 (A5)
unnamed: LED7.A, Z80.36 (A6)
unnamed: LED8.A, Z80.37 (A7)
unnamed: S1.2, Z80.26 (RESET)
unnamed: R17.P$2 (2), S1.1
unnamed: IC1.7 (DIS), R18.P$1 (1), R19.P$1 (1)
unnamed: C3.+ (1), IC1.2 (TR), IC1.6 (THR), POT.2 (S)
unnamed: C2.+ (1), IC1.5 (CV)
unnamed: POT.3 (E), R19.P$2 (2)
VCC: C1.+ (1), IC1.4 (R), IC1.8 (V+), R17.P$1 (1), R18.P$2 (2), Z80.11 (VCC), Z80.16 (INT), Z80.17 (NMI), Z80.24 (WAIT), Z80.25 (BUSRQ)

Notes on the sheet:
CLOCK
