MatthewWCook/Z80Project/Z80 UART Serial Console Interface/Schematic/KiCAD/Z80USCI.sch

## KiCad design Z80 UART Serial Console Interface/Schematic/KiCAD/Z80USCI.sch (2015-04-05)

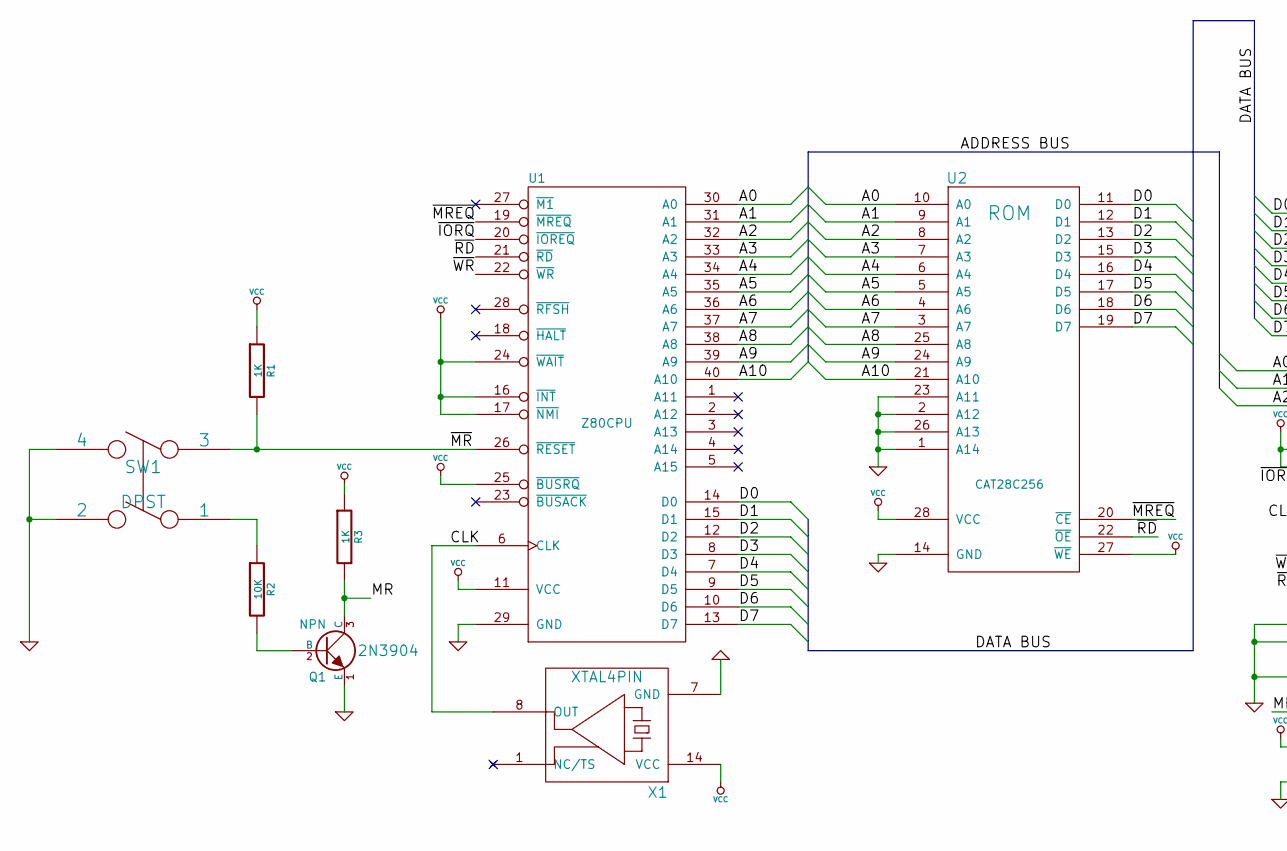
[picture p32: schematic Z80USCI.sch, part in row 1, column 1]

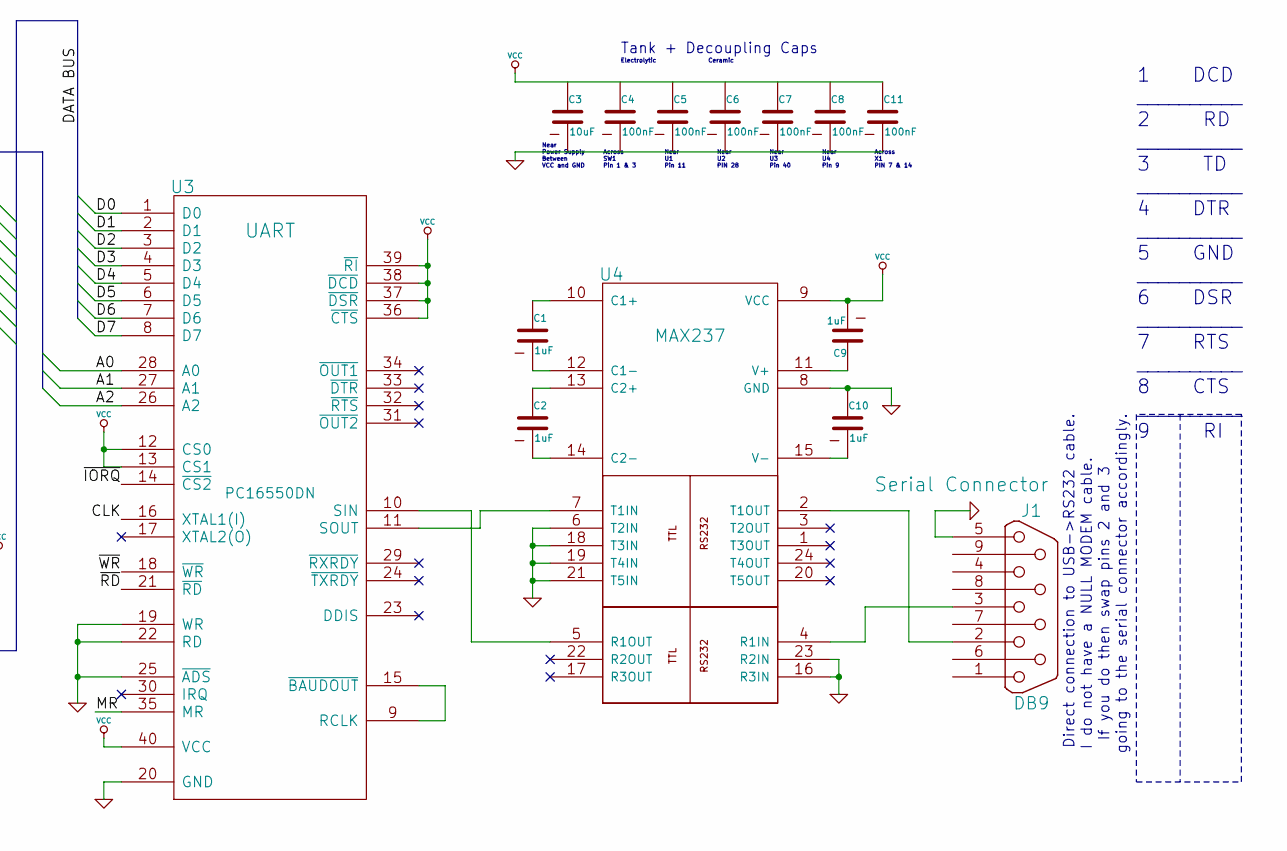
[picture p33: schematic Z80USCI.sch, part in row 1, column 2]

Parts:
C1, C2, C9, C10: 1uF
C3: 10uF
C4, C5, C6, C7, C8, C11: 100nF
J1: DB9; Part Description Serial Connector
Q1: NPN; Part 2N3904
R1, R3: 1K
R2: 10K
SW1: DPST
U1: Z80CPU
U2: CAT28C256; Part Description ROM
U3: PC16550DN; Part Description UART
U4: MAX237
X1: XTAL4PIN

Connections:
A0: U1.30 (A0), U2.10 (A0), U3.28 (A0)
A1: U1.31 (A1), U2.9 (A1), U3.27 (A1)
A2: U1.32 (A2), U2.8 (A2), U3.26 (A2)
A3: U1.33 (A3), U2.7 (A3)
A4: U1.34 (A4), U2.6 (A4)
A5: U1.35 (A5), U2.5 (A5)
A6: U1.36 (A6), U2.4 (A6)
A7: U1.37 (A7), U2.3 (A7)
A8: U1.38 (A8), U2.25 (A8)
A9: U1.39 (A9), U2.24 (A9)
A10: U1.40 (A10), U2.21 (A10)
CLK: U1.6 (CLK), U3.16 (XTAL1(I)), X1.8 (OUT)
D0: U1.14 (D0), U2.11 (D0), U3.1 (D0)
D1: U1.15 (D1), U2.12 (D1), U3.2 (D1)
D2: U1.12 (D2), U2.13 (D2), U3.3 (D2)
D3: U1.8 (D3), U2.15 (D3), U3.4 (D3)
D4: U1.7 (D4), U2.16 (D4), U3.5 (D4)
D5: U1.9 (D5), U2.17 (D5), U3.6 (D5)
D6: U1.10 (D6), U2.18 (D6), U3.7 (D6)
D7: U1.13 (D7), U2.19 (D7), U3.8 (D7)
GND: C10.1, C11.2, J1.5, Q1.1 (E), SW1.2, SW1.4, U1.29 (GND), U2.1 (A14), U2.2 (A12), U2.14 (GND), U2.23 (A11), U2.26 (A13), U3.19 (WR), U3.20 (GND), U3.22 (RD), U3.25 (~ADS), U4.6 (T2IN), U4.8 (GND), U4.16 (R3IN), U4.18 (T3IN), U4.19 (T4IN), U4.21 (T5IN), U4.23 (R2IN), X1.7 (GND)
MR: Q1.3 (C), R3.2, U3.35 (MR)
unnamed: C1.1, U4.10 (C1+)
unnamed: C1.2, U4.12 (C1-)
unnamed: C2.1, U4.13 (C2+)
unnamed: C2.2, U4.14 (C2-)
unnamed: C9.1, U4.11 (V+)
unnamed: C10.2, U4.15 (V-)
unnamed: J1.2, U4.2 (T1OUT)
unnamed: J1.3, U4.4 (R1IN)
unnamed: Q1.2 (B), R2.2
unnamed: R2.1, SW1.1
unnamed: U3.10 (SIN), U4.5 (R1OUT)
unnamed: U3.11 (SOUT), U4.7 (T1IN)
unnamed: U3.9 (RCLK), U3.15 (~BAUDOUT)
VCC: C9.2, C11.1, R1.1, R3.1, U1.11 (VCC), U1.16 (~INT), U1.17 (~NMI), U1.24 (~WAIT), U1.25 (~BUSRQ), U2.27 (~WE), U2.28 (VCC), U3.12 (CS0), U3.13 (CS1), U3.36 (~CTS), U3.37 (~DSR), U3.38 (~DCD), U3.39 (~RI), U3.40 (VCC), U4.9 (VCC), X1.14 (VCC)
~IORQ: U1.20 (~IOREQ), U3.14 (~CS2)
~MR: R1.2, SW1.3, U1.26 (~RESET)
~MREQ: U1.19 (~MREQ), U2.20 (~CE)
~RD: U1.21 (~RD), U2.22 (~OE), U3.21 (~RD)
~WR: U1.22 (~WR), U3.18 (~WR)

Notes on the sheet:
Direct connection to USB->RS232 cable.
1 DCD __________ 2 RD __________ 3 TD __________ 4 DTR __________ 5 GND __________ 6 DSR __________ 7 RTS __________ 8 CTS __________ 9 RI
Tank + Decoupling Caps
I do not have a NULL MODEM cable.
If you do then swap pins 2 and 3
going to the serial connector accordingly.
Near Power Supply Between VCC and GND
Across SW1 Pin 1 & 3
Near U1 Pin 11
Near U2 PIN 28
Near U3 Pin 40
Near U4 Pin 9
Across X1 PIN 7 & 14
Electrolytic
Ceramic
