MatthewWCook/Z80Project/Z80 UART Transmit Test/Schematic/Eagle/Z80UARTTEST.sch

## EAGLE design Z80 UART Transmit Test/Schematic/Eagle/Z80UARTTEST.sch (2015-04-02)

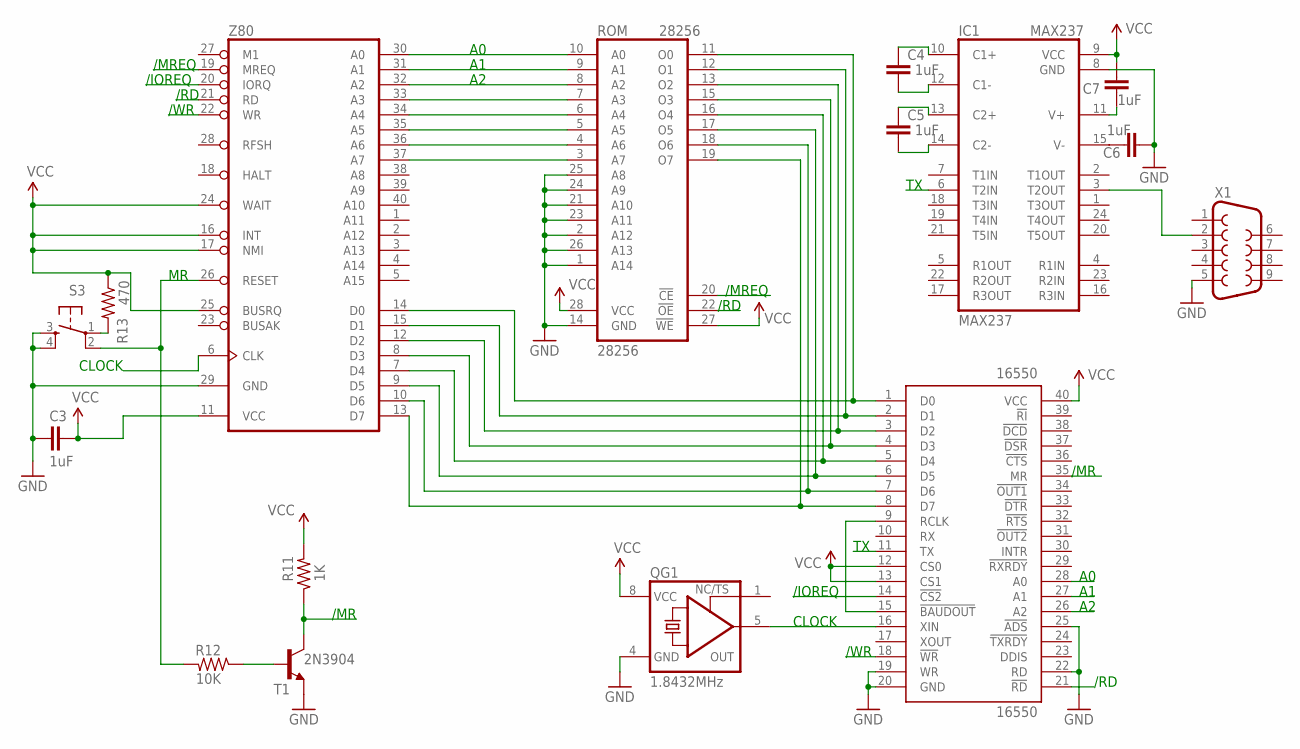
[picture p34: schematic Z80UARTTEST.sch]

Parts:
C3, C4, C5, C6, C7: 1uF; E5-5
IC1: MAX237; DIL24-3
QG1: 1.8432MHz; DIL08S
R11: 1K; AXIAL-0.4
R12: 10K; AXIAL-0.4
R13: 470; AXIAL-0.4
ROM: 28256; DIL28
S3: TAC_SWITCHPTH; TACTILE-PTH
T1: 2N3904; TO92
U$1: 16550; DIL40
X1: DB9FEMALE; DB9
Z80: Z80CPU; DIL40

Connections:
/IOREQ: U$1.14 (!CS2), Z80.20 (IORQ)
/MR: R11.P$1 (1), T1.1 (C), U$1.35 (MR)
/MREQ: ROM.20 (!CE), Z80.19 (MREQ)
/RD: ROM.22 (!OE), U$1.21 (!RD), Z80.21 (RD)
/WR: U$1.18 (!WR), Z80.22 (WR)
A0: ROM.10 (A0), U$1.28 (A0), Z80.30 (A0)
A1: ROM.9 (A1), U$1.27 (A1), Z80.31 (A1)
A2: ROM.8 (A2), U$1.26 (A2), Z80.32 (A2)
CLOCK: QG1.5 (OUT), U$1.16 (XIN), Z80.6 (CLK)
GND: C3.- (2), C6.+ (1), IC1.8 (GND), QG1.4 (GND), ROM.1 (A14), ROM.2 (A12), ROM.14 (GND), ROM.21 (A10), ROM.23 (A11), ROM.24 (A9), ROM.25 (A8), ROM.26 (A13), S3.3, S3.4, T1.3 (E), U$1.19 (WR), U$1.20 (GND), U$1.22 (RD), U$1.25 (!ADS), X1.5, Z80.29 (GND)
MR: R12.P$2 (2), S3.2, Z80.26 (RESET)
unnamed: U$1.9 (RCLK), U$1.15 (!BAUDOUT)
unnamed: ROM.11 (O0), U$1.1 (D0), Z80.14 (D0)
unnamed: C4.+ (1), IC1.10 (C1+)
unnamed: C4.- (2), IC1.12 (C1-)
unnamed: C5.+ (1), IC1.13 (C2+)
unnamed: C5.- (2), IC1.14 (C2-)
unnamed: C6.- (2), IC1.15 (V-)
unnamed: C7.+ (1), IC1.11 (V+)
unnamed: ROM.12 (O1), U$1.2 (D1), Z80.15 (D1)
unnamed: IC1.3 (T2OUT), X1.2
unnamed: ROM.13 (O2), U$1.3 (D2), Z80.12 (D2)
unnamed: ROM.15 (O3), U$1.4 (D3), Z80.8 (D3)
unnamed: ROM.16 (O4), U$1.5 (D4), Z80.7 (D4)
unnamed: ROM.17 (O5), U$1.6 (D5), Z80.9 (D5)
unnamed: ROM.18 (O6), U$1.7 (D6), Z80.10 (D6)
unnamed: ROM.19 (O7), U$1.8 (D7), Z80.13 (D7)
unnamed: ROM.7 (A3), Z80.33 (A3)
unnamed: ROM.6 (A4), Z80.34 (A4)
unnamed: ROM.5 (A5), Z80.35 (A5)
unnamed: ROM.4 (A6), Z80.36 (A6)
unnamed: ROM.3 (A7), Z80.37 (A7)
unnamed: R12.P$1 (1), T1.2 (B)
unnamed: R13.P$2 (2), S3.1
TX: IC1.6 (T2IN), U$1.11 (TX)
VCC: C3.+ (1), C7.- (2), IC1.9 (VCC), QG1.8 (VCC), R11.P$2 (2), R13.P$1 (1), ROM.27 (!WE), ROM.28 (VCC), U$1.12 (CS0), U$1.13 (CS1), U$1.40 (VCC), Z80.11 (VCC), Z80.16 (INT), Z80.17 (NMI), Z80.24 (WAIT), Z80.25 (BUSRQ)

Notes on the sheet:
CLOCK
/RD
/MREQ
/IOREQ
/WR
/MR
16550
