MatthewWCook/Z80Project/Z80 8bit CF Card Part 1/Code/IOMAP.asm

;***************************************************************************
;  PROGRAM:			IOMap       
;  PURPOSE:			Base addresses for I/O Map
;  ASSEMBLER:		TASM 3.2        
;  LICENCE:			The MIT Licence
;  AUTHOR :			MCook
;  CREATE DATE :	19 June 15
;***************************************************************************

;I/O Map base addresses
UARTBASE:	.EQU	$00			;UART base address
CFBASE:		.EQU    $20			;CF Card base address
