MatthewWCook/Z80Project/(commit log)

2015-04-02 Copy existing data
    Took all data from WordPress and placed into GitHub
    [LFSWG.sch, UARTCONSOLE.obj, Z80RT.sch, Z80UARTTEST.sch, Z80USCI.sch, z80testcircuit.sch]
2015-04-05 Housekeeping
    Re-structured the existing data to standardize posts.
    [LFSWG.sch, Z80RT.sch, Z80TestCircuit.sch, Z80UARTTEST.sch, Z80USCI.sch]
2015-04-12 Add Z80 RAM and Stack Test
    standard new post update
    [STACKTEST.obj, Z80RAMSTACKTEST.sch]
2015-04-29 Add Z80 Interrupt and Strings
    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
    [Z80INTERRUPTS.sch, Z80Interrupt.obj]
2015-05-21 Z80 Monitor Part 1
    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
    [Z80Monitor.obj]
2015-07-06 Z80 8bit CF Card Part 1
    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
    [Z80CFHDD.sch, Z80Monitor.obj]
